maker-lab-9000/pi-film-reversal/docs/sticks3-remote.md

# StickS3 remote capture and Pi deployment

This guide connects the M5StickS3 button to the Pi's authenticated capture API.
The Pi runs its own Wi-Fi hotspot and the Stick joins it directly; no home
network sits between them. Administration (SSH, photo transfer, updates) goes
over an Ethernet cable, either straight into a laptop or into a router.

The examples use account `george`, hostname `pifilm`, project checkout
`/home/george/repos/pi-film-reversal`, hotspot `pifilm-cam` at `10.42.0.1`.
Keep credentials in the ignored local `.env`; never paste them into a shell
command, firmware source, service unit, terminal transcript, or Git commit.

## Local configuration

On the Mac or Pi checkout, make the local file with restrictive permissions:

```sh
cp .env.example .env
chmod 600 .env
```

Set these values in `.env`:

```dotenv
PI_HOST=parr.local
PI_USER=george
PI_PROJECT_DIR=/home/george/repos/pi-film-reversal
PI_SSH_PASSWORD=replace-locally
WIFI_SSID=pifilm-cam
WIFI_PASSWORD=replace-locally-8-to-63-ascii-characters
PIFILM_REMOTE_URL=http://10.42.0.1:8765
PIFILM_LISTEN=0.0.0.0:8765
PIFILM_REMOTE_TOKEN=replace-locally-with-a-long-random-token
PI_ARTIFACT_DIR=/home/george/repos/pi-film-reversal/pifilm/data
```

What each group means in this topology:

- `PI_HOST` is where SSH goes. Over Ethernet with avahi running on the Pi that
  is the mDNS name `parr.local`; a plain IP address also works.
- `WIFI_SSID` and `WIFI_PASSWORD` are the **Pi's hotspot** credentials. The
  Stick joins this network. WPA2 requires 8 to 63 printable ASCII characters.
- `PIFILM_REMOTE_URL` is the address the Stick calls. Its host must be a plain
  IPv4 address, and `scripts/pi_hotspot.py` gives the hotspot exactly that
  address, so the two can never disagree.
- `PIFILM_LISTEN` is where `pifilm-capture` binds on the Pi. `0.0.0.0:8765`
  listens on both the hotspot and Ethernet and avoids a boot-order race with
  NetworkManager bringing the hotspot address up.
- `PI_ARTIFACT_DIR` is the look the service loads. `pifilm/data` is the bundled
  untrained starter and exists in every checkout. A trained model under
  `artifacts/` is gitignored and must be copied to the Pi first. Whatever you
  choose, use the same path in the service unit's `--artifacts` and verify it
  on the Pi before starting capture: it must contain both `params.json` and
  `pifilm.cube`. Each capture's `captures.jsonl` record carries the `lut_sha1` of
  the look that graded it, so you can always tell which one was in use.

The scripts parse this file as `KEY=VALUE` data. They do not source it, expand
variables, run command substitutions, or execute any of its contents. The Pi
SSH password is used only for the SSH connection. The firmware generator passes
only Wi-Fi SSID, Wi-Fi password, API URL, and remote token to PlatformIO; it
never writes a credentials file and never passes `PI_SSH_PASSWORD` to firmware.
The hotspot script writes a root-only NetworkManager keyfile rather than passing
the passphrase on a command line.

Install the optional, cross-platform SSH dependency before using deployment:

```sh
.venv/bin/python --version  # requires Python 3.11 or newer
.venv/bin/python -m pip install --upgrade pip
.venv/bin/python -m pip install -e '.[deploy]'
```

If the environment uses an older Python, preserve it and recreate it first
(on macOS with Python 3.12 installed):

```sh
mv .venv .venv-old
python3.12 -m venv .venv
```

Then run the installation commands above. Pip 21.2.4 cannot install this
project in editable mode; upgrading pip fixes that error only when the Python
version also meets the project requirement.

## Network topology: Pi hotspot and Ethernet administration

The Pi 3B's onboard radio (2.4 GHz b/g/n) supports access-point mode with the
standard `brcmfmac` driver. The ESP32-S3 in the Stick is 2.4 GHz only, and the
firmware joins with `WiFi.begin(ssid, password)`, which is plain WPA2-PSK. No
firmware code changes are needed; only a rebuild with the hotspot's SSID,
passphrase and API URL.

One radio cannot reliably be a client of your home Wi-Fi and an access point at
the same time. **Activating the hotspot disconnects the Pi from home Wi-Fi.**
Do the steps below with an Ethernet cable connected, in this order.

Verified 2026-09-08 on a Pi 3B running Raspberry Pi OS Trixie (Debian 13),
NetworkManager 1.52.1 with netplan-generated profiles, brcmfmac firmware
7.45.98. Hotspot and capture service both return unattended after a reboot.

### 1. Ethernet administration (do this first)

Plug the Pi into your router, or directly into the laptop (the Pi 3B port is
auto-MDI-X, so any patch cable works). Log in and give the Pi a memorable name:

```sh
sudo raspi-config nonint do_hostname pifilm
```

Make the wired connection usable both behind a router (DHCP) and on a direct
cable with no DHCP server (IPv4 link-local, `169.254.x.y`):

```sh
nmcli -t -f NAME,TYPE connection show | grep ethernet   # find the wired profile name
sudo nmcli connection modify <wired-profile> ipv4.method auto ipv4.link-local enabled
nmcli -f ipv4.method,ipv4.link-local connection show <wired-profile>
```

The profile name depends on the OS release: Bookworm images call it
`Wired connection 1`; Trixie images, where netplan generates the
NetworkManager profiles, call it `netplan-eth0`. On Trixie, check that the
change was persisted and not only applied to the generated copy in `/run`:
a new `/etc/netplan/90-NM-<uuid>.yaml` (or a keyfile under
`/etc/NetworkManager/system-connections/`) should appear, and the property
must still read `enabled` after a reboot.

`ipv4.link-local` needs NetworkManager 1.40 or newer (`nmcli --version`);
Bookworm ships 1.42 and Trixie 1.52. If the property is missing, add a second
static profile on `192.168.7.2/24` and set the Mac's Ethernet adapter to
`192.168.7.1` instead.

avahi is installed by default on Raspberry Pi OS, and macOS resolves `.local`
names natively, so after a reboot both of these work with a direct cable:

```sh
ssh george@parr.local
ping parr.local
```

To give the Pi internet through the laptop for `apt` and `pip`, enable macOS
Internet Sharing from Wi-Fi to the Ethernet port; the Pi then receives a
`192.168.2.x` address over DHCP.

### 2. Wi-Fi country

Without a regulatory domain the radio stays soft-blocked and the hotspot will
not come up. Use your two-letter country code:

```sh
sudo raspi-config nonint do_wifi_country DE
```

### 3. Create the hotspot from `.env`

Copy the completed `.env` to the Pi checkout (mode 600), then preview the
NetworkManager keyfile the script will write. The passphrase is redacted in the
preview and nothing is written:

```sh
cd /home/george/repos/pi-film-reversal
.venv/bin/python scripts/pi_hotspot.py --env .env
```

With the Ethernet session confirmed working, apply it:

```sh
sudo .venv/bin/python scripts/pi_hotspot.py --env .env --apply
nmcli connection show --active
```

The script writes `/etc/NetworkManager/system-connections/pifilm-ap.nmconnection`
with mode 0600, reloads NetworkManager and activates `pifilm-ap`. The profile is
an access point on `wlan0`, WPA2-PSK only, `ipv4.method shared` (NetworkManager
runs a DHCP server for the Stick on the `/24` around the hotspot address and
NATs to Ethernet when that is up), `autoconnect` with priority 10. Re-running
with the same SSID produces the same connection UUID, so applying twice
replaces rather than duplicates.

The profile also sets `pmf=1`, which disables Protected Management Frames.
NetworkManager's default is "optional", and that makes hostapd install an
AES-CMAC group key when the access point starts. The Pi 3B and Zero W radio
(BCM43430, firmware 7.45.98) has no management-frame protection, `iw list`
shows no CMAC cipher, and the kernel rejects the key. The visible symptom is
`nmcli` failing with "802.1X supplicant took too long to authenticate" and
`journalctl -u wpa_supplicant` showing `key setting validation failed` followed
by `Failed to initialize AP interface`. The Pi 3B+ and Pi 4 radios do support
it, which is why generic hotspot recipes work there without this line. The
Stick does not use PMF, so nothing is lost.

If the Pi previously joined your home Wi-Fi, stop that profile from competing
at boot. The Imager-created profile is named `preconfigured` on Bookworm and
`netplan-wlan0-<SSID>` on Trixie; take the name from the listing:

```sh
nmcli -t -f NAME,TYPE connection show | grep wireless
sudo nmcli connection modify <home-wifi-profile> connection.autoconnect no
```

Expect 10 to 20 seconds after Pi boot before the hotspot is up. The firmware
already backs off reconnects between 1 and 10 seconds, so the Stick settles
into READY on its own.

### 4. Point the service and the firmware at the hotspot

The systemd example already listens on `0.0.0.0:8765`. Install or update it as
described in the next section, then rebuild and flash the Stick as described in
"Generate and flash StickS3 configuration" so it carries the hotspot SSID,
passphrase and `http://10.42.0.1:8765`.

The API is plain HTTP with a bearer token. On a private WPA2 hotspot with a
strong passphrase that is acceptable; keep the token anyway so a guest on the
hotspot cannot fire the shutter. The Ethernet side also sees port 8765 when
listening on `0.0.0.0`; the same token protects it.

### 5. Verify

From a phone or laptop joined to `pifilm-cam` (or from the Pi itself):

```sh
curl -s -H "Authorization: Bearer $PIFILM_REMOTE_TOKEN" http://10.42.0.1:8765/v1/status
```

Expect `"ready":true`. `"pi_battery"` is always present; it is `null` unless
the service runs with `--ups x728`. Allow up to 30 seconds after a boot
before the port answers: the service imports OpenCV, loads the LUT and warms
up the camera first, and on a Pi 3B that takes 15 to 25 seconds. Then power
the Stick: colour
bars, READY, one capture per deliberate press, graded thumbnail displayed. The
Stick's serial log shows each step; `firmware/sticks3/README.md` explains how to
read it and how to prove the displayed image is the graded file. The small side
button (BtnB) turns the Stick's screen off and back on to save battery; the
shutter keeps working while the screen is dark, and a new photo does not wake
it. Pull photos
over Ethernet with:

```sh
rsync -av george@parr.local:Pictures/pifilm/ ~/Pictures/pifilm-pi/
```
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
