maker-lab-9000/pi-film-reversal/camera-body/stl/bayonet_ring.stl

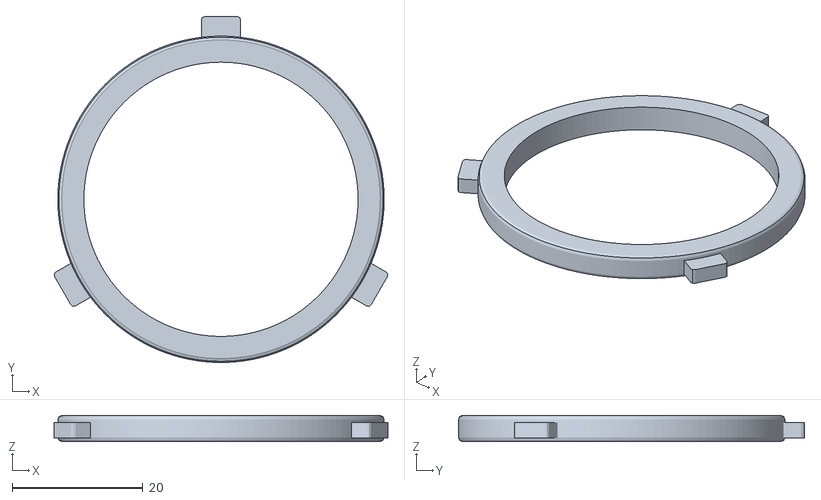
[picture p8: CAD file, 2026-11-12]
camera-body/stl/bayonet_ring.stl
51.1 x 53.0 x 4.00
