maker-lab-9000/pi-film-reversal/camera-body/stl/finder_base.stl

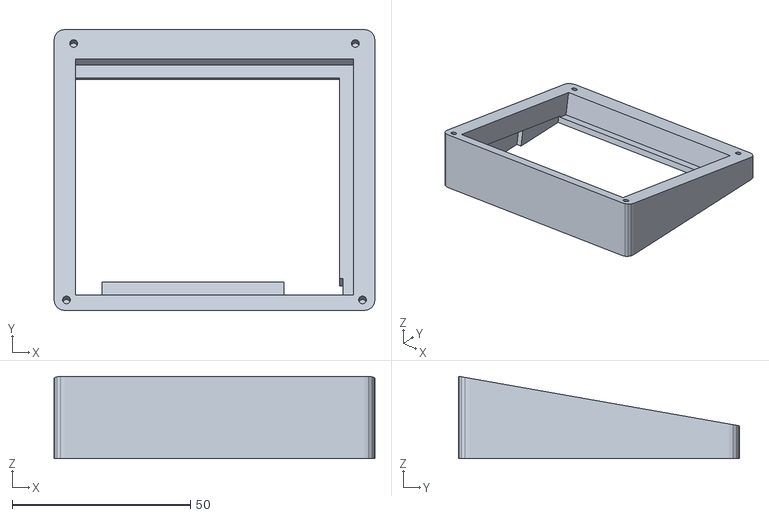
[picture p9: CAD file, 2026-11-12]
camera-body/stl/finder_base.stl
90.0 x 78.8 x 23.1
