maker-lab-9000/pi-film-reversal/camera-body/stl/sleeve.stl

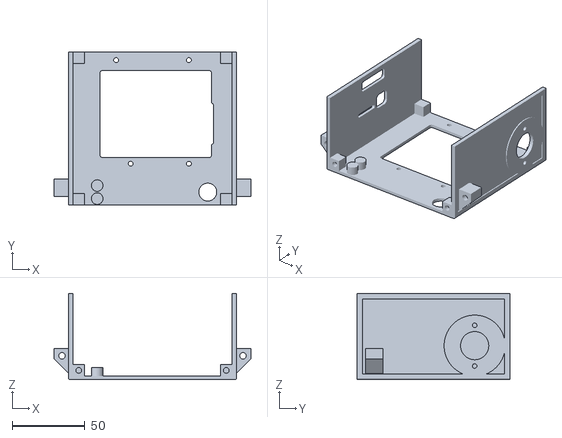
[picture p10: CAD file, 2026-11-12]
camera-body/stl/sleeve.stl
135.4 x 105.4 x 59.4
