maker-lab-9000/pi-film-reversal/camera-body/stl/base_plate.stl

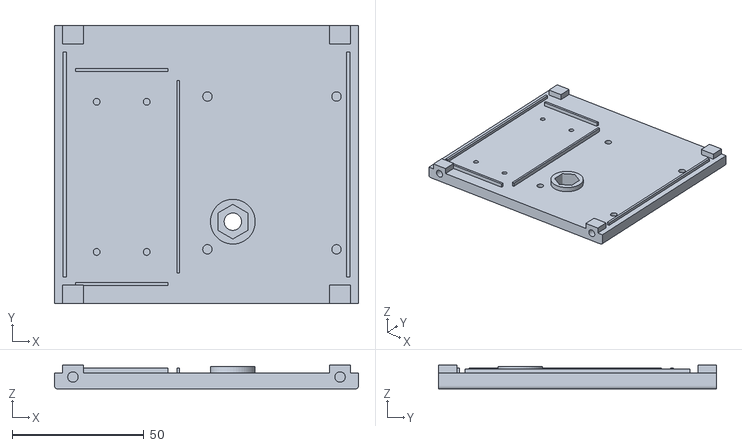
[picture p11: CAD file, 2026-11-12]
camera-body/stl/base_plate.stl
115.4 x 105.4 x 9.00
