maker-lab-9000/pi-film-reversal/camera-body/stl/power_knob.stl

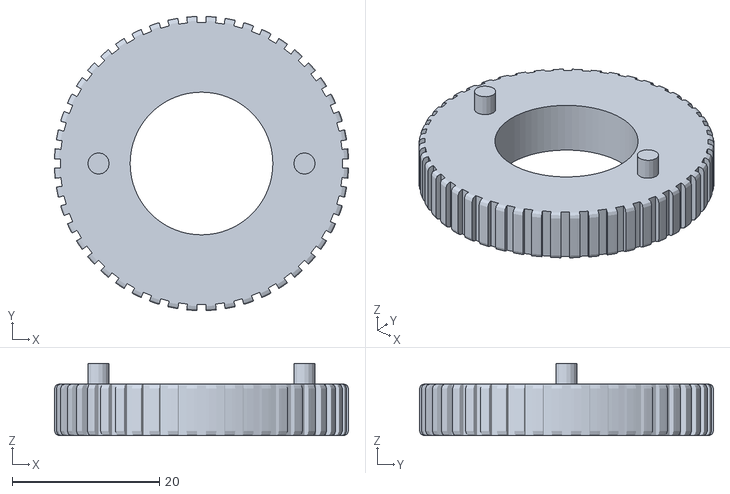
[picture p12: CAD file, 2026-11-12]
camera-body/stl/power_knob.stl
40.0 x 40.0 x 9.80
