maker-lab-9000/pi-film-reversal/camera-body/stl/coupon_right_wall.stl

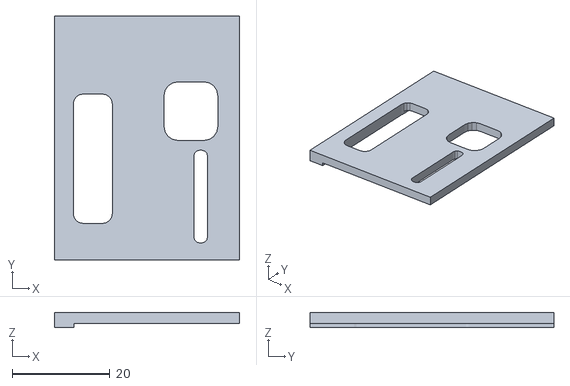
[picture p13: CAD file, 2026-11-12]
camera-body/stl/coupon_right_wall.stl
38.0 x 50.0 x 3.00
