maker-lab-9000/pi-film-reversal/camera-body/stl/lens_board.stl

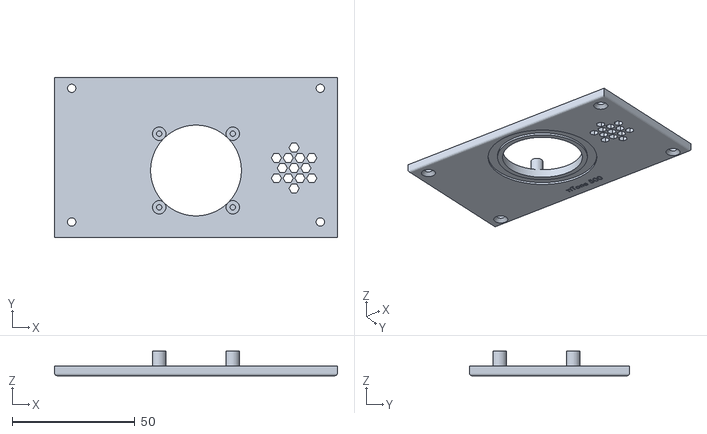
[picture p14: CAD file, 2026-11-12]
camera-body/stl/lens_board.stl
115.4 x 65.4 x 10.0
