maker-lab-9000/pi-film-reversal/camera-body/stl/cold_shoe.stl

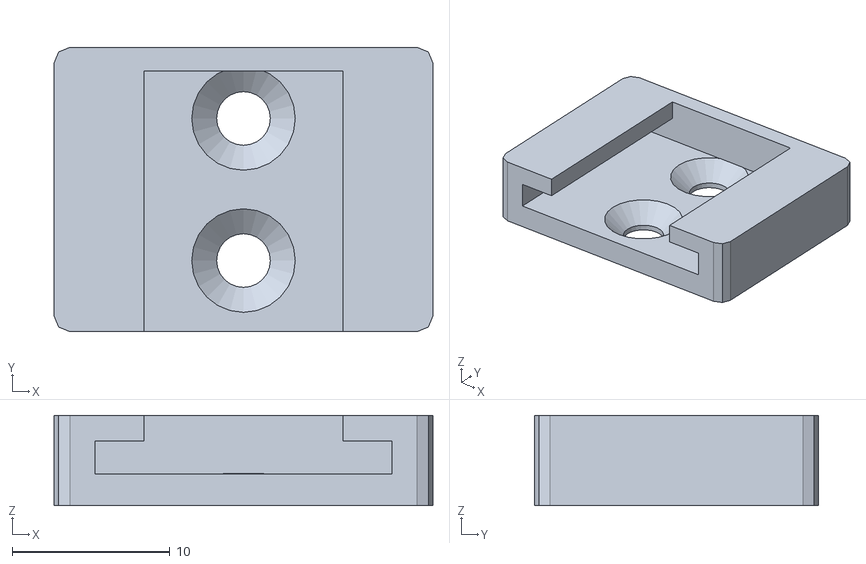
[picture p15: CAD file, 2026-11-12]
camera-body/stl/cold_shoe.stl
24.0 x 18.0 x 5.70
