maker-lab-9000/pi-film-reversal/camera-body/stl/shutter_collar.stl

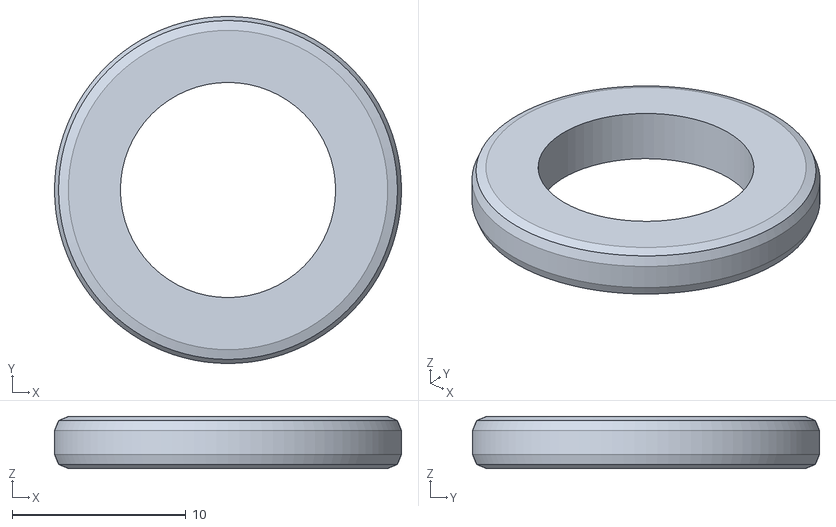
[picture p16: CAD file, 2026-11-12]
camera-body/stl/shutter_collar.stl
20.0 x 20.0 x 3.00
