maker-lab-9000/pi-film-reversal/camera-body/stl/hood_flap_l.stl

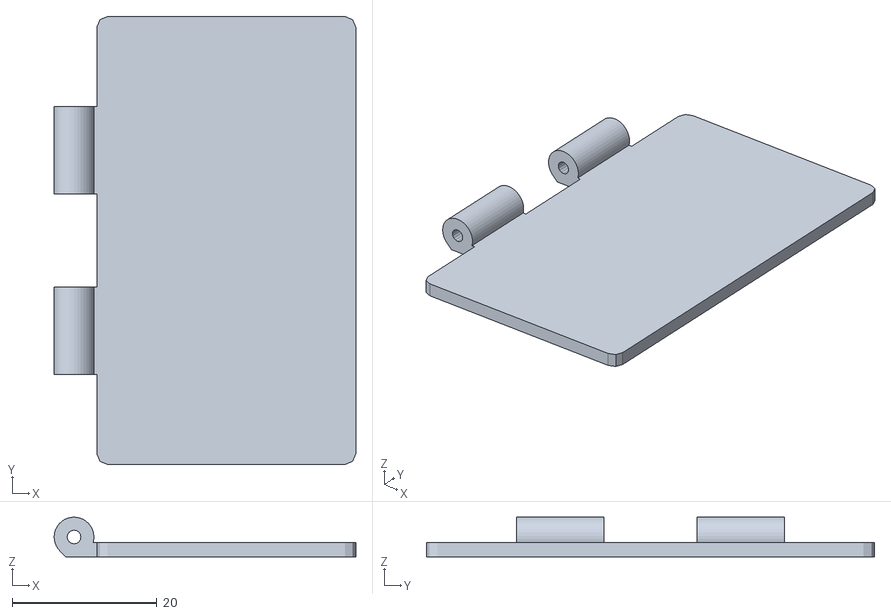
[picture p17: CAD file, 2026-11-12]
camera-body/stl/hood_flap_l.stl
41.7 x 62.0 x 5.50
