maker-lab-9000/pi-film-reversal/docs/superpowers/mockups/2026-10-11-manual-controls-ui.png

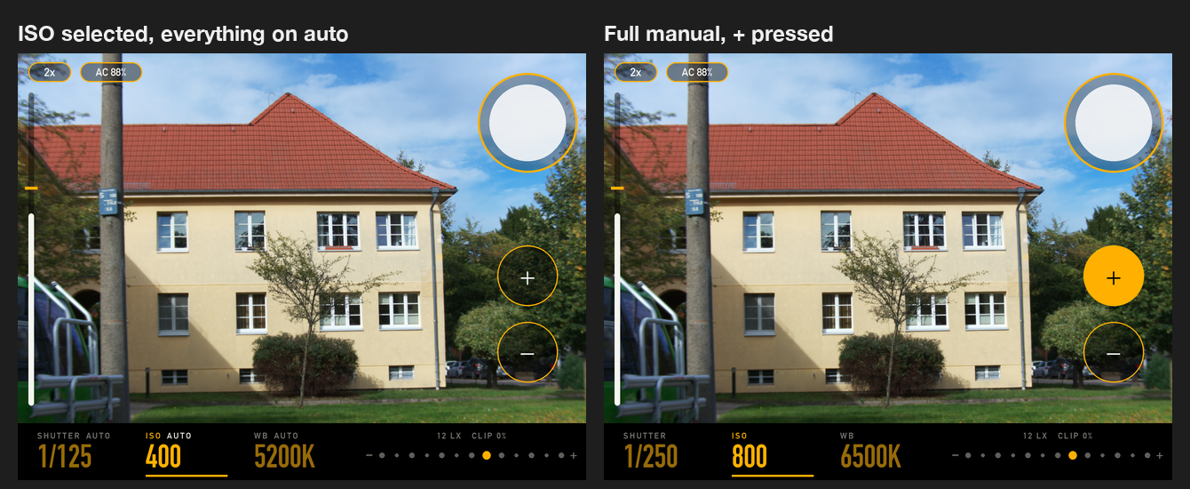
docs/superpowers/mockups/2026-10-11-manual-controls-ui.png
