maker-lab-9000/pi-film-reversal/tests/test_capture_controller.py

from __future__ import annotations

import threading
import time
from dataclasses import dataclass
from unittest.mock import Mock

import pytest

from pifilm.capture.camera import CameraError
from pifilm.capture.controller import CaptureController, ControllerSnapshot


@dataclass
class Result:
    value: str


class BlockingSession:
    def __init__(self) -> None:
        self.started = threading.Event()
        self.release = threading.Event()
        self.calls = 0
        self.camera = Mock()

    def capture(self) -> Result:
        self.calls += 1
        self.started.set()
        self.release.wait(timeout=2)
        return Result("saved")


def wait_for(controller, request_id: str, state: str):
    for _ in range(200):
        job = controller.status(request_id)
        if job is not None and job.state == state:
            return job
        threading.Event().wait(0.01)
    raise AssertionError(f"job {request_id!r} did not become {state!r}")


def test_controller_captures_once_for_an_accepted_request():
    """Removing the single worker's capture call would leave the job unfinished."""
    from pifilm.capture.controller import CaptureController

    session = BlockingSession()
    controller = CaptureController(session)
    try:
        accepted = controller.submit("first")
        assert accepted.request_id == "first"
        assert accepted.state in {"queued", "processing"}
        assert session.started.wait(timeout=1)
        assert session.calls == 1
        session.release.set()
        complete = wait_for(controller, "first", "complete")
        assert complete.result == Result("saved")
        assert session.calls == 1
    finally:
        session.release.set()
        controller.close()


def test_controller_allows_only_one_active_job_and_returns_busy_for_another_id():
    """Dropping the active-job guard would start a second camera capture."""
    from pifilm.capture.controller import CaptureController

    session = BlockingSession()
    controller = CaptureController(session)
    try:
        controller.submit("first")
        assert session.started.wait(timeout=1)
        busy = controller.submit("second")
        assert busy.request_id == "second"
        assert busy.state == "failed"
        assert busy.error_code == "busy"
        assert controller.status("second") is None
        assert session.calls == 1
    finally:
        session.release.set()
        controller.close()


def test_controller_duplicate_id_returns_the_original_job_without_recapturing():
    """Treating a duplicate as new would make retries expose the camera twice."""
    from pifilm.capture.controller import CaptureController

    session = BlockingSession()
    controller = CaptureController(session)
    try:
        original = controller.submit("same")
        assert session.started.wait(timeout=1)
        duplicate = controller.submit("same")
        assert duplicate == controller.status("same")
        assert duplicate.request_id == original.request_id
        assert duplicate.error_code is None
        assert session.calls == 1
    finally:
        session.release.set()
        controller.close()


def test_camera_error_finishes_job_and_allows_a_later_request():
    """Keeping a failed job active would make the camera permanently busy."""
    from pifilm.capture.controller import CaptureController

    class FlakySession:
        def __init__(self) -> None:
            self.calls = 0
            self.camera = Mock()

        def capture(self):
            self.calls += 1
            if self.calls == 1:
                raise CameraError("dropped frame")
            return Result("recovered")

    session = FlakySession()
    controller = CaptureController(session)
    try:
        failed = wait_for(controller, controller.submit("failed").request_id, "failed")
        assert failed.error_code == "camera_error"
        complete = wait_for(controller, controller.submit("retry").request_id, "complete")
        assert complete.result == Result("recovered")
        assert session.calls == 2
    finally:
        controller.close()


def test_snapshots_are_immutable_values():
    """Mutating a returned status must not change the controller's published state."""
    from dataclasses import FrozenInstanceError

    from pifilm.capture.controller import CaptureController

    session = BlockingSession()
    controller = CaptureController(session)
    try:
        job = controller.submit("first")
        try:
            job.state = "failed"
        except FrozenInstanceError:
            pass
        else:
            raise AssertionError("job snapshot was mutable")
    finally:
        session.release.set()
        controller.close()


class _Session:
    def __init__(self, fail=False):
        self.camera = None
        self.fail = fail

    def capture(self):
        if self.fail:
            raise CameraError("boom")
        return "result"


def _wait_finished(controller, request_id, timeout=2.0):
    deadline = time.monotonic() + timeout
    while time.monotonic() < deadline:
        job = controller.status(request_id)
        if job is not None and job.state in ("complete", "failed"):
            return job
        time.sleep(0.005)
    raise AssertionError("job did not finish")


def test_snapshot_counts_finished_jobs_of_both_states():
    controller = CaptureController(_Session())
    try:
        assert controller.snapshot().finished_count == 0
        assert controller.snapshot().last_finished_job is None
        controller.submit("a")
        _wait_finished(controller, "a")
        snap = controller.snapshot()
        assert snap.finished_count == 1
        assert snap.last_finished_job.request_id == "a"
        assert snap.last_finished_job.state == "complete"
    finally:
        controller.close()


def test_failed_job_counts_as_finished_but_not_completed():
    controller = CaptureController(_Session(fail=True))
    try:
        controller.submit("b")
        _wait_finished(controller, "b")
        snap = controller.snapshot()
        assert snap.finished_count == 1
        assert snap.last_finished_job.state == "failed"
        assert snap.last_completed_job is None
    finally:
        controller.close()


class DoubleSession:
    """Minimal session with the double-exposure surface of ``CaptureSession``."""

    def __init__(self) -> None:
        self.camera = Mock()
        self.enabled = False
        self.taken = 0
        self.started = threading.Event()
        self.release = threading.Event()
        self.release.set()

    @property
    def double_state(self):
        return self.enabled, self.taken

    def set_double_exposure(self, enabled):
        self.enabled = enabled
        if not enabled:
            self.taken = 0

    def capture(self):
        self.started.set()
        self.release.wait(timeout=2)
        if self.enabled:
            self.taken = (self.taken + 1) % 2
        return Result("saved")


def _until(pred):
    for _ in range(200):
        if pred():
            return
        threading.Event().wait(0.01)
    raise AssertionError("condition not met")


def test_double_exposure_toggle_reaches_the_snapshot():
    session = DoubleSession()
    controller = CaptureController(session)
    try:
        assert controller.snapshot().double_exposure is False
        controller.set_double_exposure(True)
        _until(lambda: controller.snapshot().double_exposure)
        assert controller.snapshot().exposures_taken == 0
    finally:
        controller.close()


def test_a_finished_job_and_its_exposure_count_arrive_in_one_snapshot():
    """A display must never see exposure 1 finished with the count still at 0."""
    session = DoubleSession()
    controller = CaptureController(session)
    try:
        controller.set_double_exposure(True)
        _until(lambda: controller.snapshot().double_exposure)
        controller.submit("one")
        _until(lambda: controller.snapshot().finished_count == 1)
        snap = controller.snapshot()
        assert snap.finished_count == 1 and snap.exposures_taken == 1
    finally:
        controller.close()


def test_a_toggle_sent_during_a_capture_applies_after_it():
    session = DoubleSession()
    session.enabled = True
    session.release.clear()
    controller = CaptureController(session)
    try:
        controller.submit("busy")
        assert session.started.wait(timeout=1)
        controller.set_double_exposure(False)
        assert session.enabled is True  # not applied mid-capture
        session.release.set()
        _until(lambda: controller.snapshot().double_exposure is False)
        assert controller.snapshot().finished_count == 1
    finally:
        session.release.set()
        controller.close()


def test_a_session_without_double_exposure_ignores_the_toggle():
    session = BlockingSession()
    session.release.set()
    controller = CaptureController(session)
    try:
        controller.set_double_exposure(True)
        controller.submit("plain")
        wait_for(controller, "plain", "complete")
        assert controller.snapshot().double_exposure is False
    finally:
        controller.close()


def test_a_toggle_that_raises_does_not_stop_the_worker():
    class BrokenToggle(DoubleSession):
        def set_double_exposure(self, enabled):
            raise RuntimeError("toggle failed")

    controller = CaptureController(BrokenToggle())
    try:
        controller.set_double_exposure(True)
        controller.submit("after")
        assert _wait_finished(controller, "after").state == "complete"
        assert controller.snapshot().double_exposure is False
    finally:
        controller.close()


def test_an_unreadable_double_state_keeps_the_last_known_value():
    class Flaky(DoubleSession):
        broken = False

        @property
        def double_state(self):
            if self.broken:
                raise RuntimeError("state unavailable")
            return self.enabled, self.taken

    session = Flaky()
    controller = CaptureController(session)
    try:
        controller.set_double_exposure(True)
        _until(lambda: controller.snapshot().double_exposure)
        session.broken = True
        controller.submit("x")
        assert _wait_finished(controller, "x").state == "complete"
        assert controller.snapshot().double_exposure is True
    finally:
        controller.close()


class GradingSession:
    """Minimal session with the background-grading surface of ``CaptureSession``."""

    def __init__(self, events=None, fail_close=False) -> None:
        self.events = events if events is not None else []
        self.camera = Mock()
        self.camera.close.side_effect = lambda: self.events.append("camera")
        self.pending_grades = 0
        self.fail_close = fail_close

    def capture(self):
        return Result("saved")

    def close_grades(self, timeout=None):
        self.events.append("grades")
        if self.fail_close:
            raise RuntimeError("grades would not close")
        return True


def test_snapshot_follows_the_sessions_pending_grades():
    session = GradingSession()
    controller = CaptureController(session)
    try:
        assert controller.snapshot().pending_grades == 0
        session.pending_grades = 2
        assert controller.snapshot().pending_grades == 2
        session.pending_grades = 0
        assert controller.snapshot().pending_grades == 0
    finally:
        controller.close()


def test_a_session_without_pending_grades_reports_none():
    controller = CaptureController(_Session())
    try:
        assert controller.snapshot().pending_grades == 0
    finally:
        controller.close()


def test_unusable_pending_grades_report_none():
    """A display draws this number on every frame; it must never raise there."""

    class Raising(GradingSession):
        @property
        def pending_grades(self):
            raise RuntimeError("queue unavailable")

        @pending_grades.setter
        def pending_grades(self, value):
            pass

    for session in (Raising(), BlockingSession()):  # the second has no such attribute
        controller = CaptureController(session)
        try:
            assert controller.snapshot().pending_grades == 0
        finally:
            getattr(session, "release", threading.Event()).set()
            controller.close()
    odd = GradingSession()
    controller = CaptureController(odd)
    try:
        for value in ("3", None, 2.5, True, -1):
            odd.pending_grades = value
            assert controller.snapshot().pending_grades == 0
    finally:
        controller.close()


def test_close_finishes_the_grades_before_closing_the_camera():
    """The camera's close can hang on a stalled sensor; the grades must not wait on it."""
    session = GradingSession()
    controller = CaptureController(session)
    controller.close()
    assert session.events == ["grades", "camera"]
    controller.close()  # a second close is harmless
    assert session.events == ["grades", "camera"]


def test_close_still_closes_the_camera_when_the_grades_will_not_close():
    session = GradingSession(fail_close=True)
    controller = CaptureController(session)
    controller.close()
    assert session.events == ["grades", "camera"]


def test_snapshot_carries_the_sessions_tuning_mismatch():
    session = GradingSession()
    session.tuning_mismatch = True
    controller = CaptureController(session)
    try:
        assert controller.snapshot().tuning_mismatch is True
        session.tuning_mismatch = False
        assert controller.snapshot().tuning_mismatch is False
    finally:
        controller.close()


def test_a_session_without_tuning_mismatch_reports_false():
    controller = CaptureController(_Session())
    try:
        assert controller.snapshot().tuning_mismatch is False
    finally:
        controller.close()


def test_unusable_tuning_mismatch_reports_false():
    """Read on every frame like the developing count; it must never raise there."""

    class Raising(GradingSession):
        @property
        def tuning_mismatch(self):
            raise RuntimeError("no session state")

    controller = CaptureController(Raising())
    try:
        assert controller.snapshot().tuning_mismatch is False
    finally:
        controller.close()
    odd = GradingSession()
    controller = CaptureController(odd)
    try:
        for value in ("yes", 1, None):
            odd.tuning_mismatch = value
            assert controller.snapshot().tuning_mismatch is False
    finally:
        controller.close()


def test_snapshot_carries_the_sessions_disk_warning():
    session = GradingSession()
    session.disk_warning = (("PHOTOS", 92), ("SD", 91))
    controller = CaptureController(session)
    try:
        assert controller.snapshot().disk_warning == (("PHOTOS", 92), ("SD", 91))
        session.disk_warning = ()
        assert controller.snapshot().disk_warning == ()
    finally:
        controller.close()


def test_a_session_without_disk_warning_reports_none():
    controller = CaptureController(_Session())
    try:
        assert controller.snapshot().disk_warning == ()
    finally:
        controller.close()


def test_disk_warning_comes_before_network_and_defaults_to_empty():
    from dataclasses import fields

    assert [f.name for f in fields(ControllerSnapshot)][-2] == "disk_warning"
    assert ControllerSnapshot(None, None, False).disk_warning == ()


@pytest.mark.parametrize("value", [
    None, "PHOTOS 92%", [("PHOTOS", 92)], (("PHOTOS", "92"),), (("PHOTOS", True),),
    (("PHOTOS",),), ((7, 92),), (("PHOTOS", 92, 1),),
])
def test_unusable_disk_warning_reports_none(value):
    """Read on every frame like the developing count; anything odd reads as none."""
    session = GradingSession()
    session.disk_warning = value
    controller = CaptureController(session)
    try:
        assert controller.snapshot().disk_warning == ()
    finally:
        controller.close()


def test_a_raising_disk_warning_reports_none():
    class Raising(GradingSession):
        @property
        def disk_warning(self):
            raise RuntimeError("no session state")

    controller = CaptureController(Raising())
    try:
        assert controller.snapshot().disk_warning == ()
    finally:
        controller.close()


def test_snapshot_carries_the_sessions_network_addresses():
    session = GradingSession()
    session.network = (("ETH", "192.168.1.20"), ("WLAN", "10.42.0.1"))
    controller = CaptureController(session)
    try:
        assert controller.snapshot().network == (("ETH", "192.168.1.20"), ("WLAN", "10.42.0.1"))
        session.network = ()
        assert controller.snapshot().network == ()
    finally:
        controller.close()


def test_a_session_without_network_reports_none():
    controller = CaptureController(_Session())
    try:
        assert controller.snapshot().network == ()
    finally:
        controller.close()


def test_network_is_the_last_snapshot_field_and_defaults_to_empty():
    from dataclasses import fields

    assert [f.name for f in fields(ControllerSnapshot)][-1] == "network"
    assert ControllerSnapshot(None, None, False).network == ()


@pytest.mark.parametrize("value", [
    None, "ETH 192.168.1.20", [("ETH", "192.168.1.20")], (("ETH", 7),),
    (("ETH",),), ((7, "192.168.1.20"),), (("ETH", "192.168.1.20", 1),),
])
def test_unusable_network_reports_none(value):
    """Read on every frame like the developing count; anything odd reads as none."""
    session = GradingSession()
    session.network = value
    controller = CaptureController(session)
    try:
        assert controller.snapshot().network == ()
    finally:
        controller.close()


def test_a_raising_network_reports_none():
    class Raising(GradingSession):
        @property
        def network(self):
            raise RuntimeError("no session state")

    controller = CaptureController(Raising())
    try:
        assert controller.snapshot().network == ()
    finally:
        controller.close()
