maker-lab-9000/pi-film-reversal/(commit log)

2026-09-20 Document the face/skin-tone darkening and a measured fix suggestion
    One indoor Pi 4 frame (154239, 2026-09-20) loses a third of skin luminance under
    the starter LUT while the Phase 6 normaliser is a no-op on it: the S-curve
    darkens mid-shade skin and the 1.45x chroma boost turns it red-orange. The
    never-evaluated shadows control in experiments/candidates.py recovers skin
    lightness to within 0.011 of the original with under one 8-bit step of change
    elsewhere. Recorded as a suggestion only; more frames with faces, above all
    outdoors, are needed before touching the bundled starter.
2026-09-24 Count finished capture jobs on the controller snapshot
    Add ControllerSnapshot.finished_count and last_finished_job so a
    future LCD display can poll for any job that ended, complete or
    failed, regardless of which trigger (Stick, SPACE, LCD) submitted it.
    last_completed_job keeps its existing complete-only meaning for the
    remote server.
    [controller.py, test_capture_controller.py]
2026-09-24 Picamera2 backend: native size from the sensor, automatic tuning, fixed-lens sensors
    The backend was written against the IMX708 only: 4608x2592 hard-coded,
    imx708_wide.json loaded by default, and AfMode/AfRange set unconditionally.
    An IMX477 (4056x3040, 12-bit raw, fixed C/CS mount, no AfMode control) could
    not be opened at all.
    Native size now comes from Picamera2.sensor_resolution and is carried on
    self._native_size, used by create_still_configuration, the negotiated-config
    check and the frame shape check. Tuning defaults to libcamera's own choice for
    the detected sensor and is recorded as "auto:<Model>"; --tuning-file still
    pins a specific file. Autofocus controls are applied only when t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
    [app.py, camera.py, picamera.py, test_app.py, test_picamera.py]
2026-09-24 Picamera2 preview mode with per-shot mode switch, request lock and runtime EV
    The LCD viewfinder needs cheap frames on one thread while the capture
    controller takes full-resolution stills on another. The still configuration is
    still configured and validated first, so stream_info describes the shot; the
    binned preview configuration is then applied on top, and each full read uses
    switch_mode_and_capture_request, which restores the preview configuration
    itself. One lock spans request acquisition through release because the buffer
    belongs to the request, and set_ev takes the same lock.
    Without preview=, the configuration calls and read path are unchanged.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
2026-09-24 Fail loudly when Picamera2 cannot describe its own capabilities
    camera_controls and camera_properties were read through getattr with {}
    defaults while sensor_resolution on the neighbouring line was accessed
    directly. A camera missing its control set therefore fell into the
    fixed-lens path and, with --autofocus auto, reported "<model> has no
    autofocus" — sending the user after their flag instead of the real fault.
    A missing camera_properties was quieter still: the model silently became
    "unknown" and the capture was recorded as tuning_file auto:unknown.
    Both are now read directly, so a missing attribute surfaces through the
    existing constructor wrapper ("Failed to configure or start Picamer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
    [picamera.py, test_picamera.py]
2026-09-24 ST7789 driver for the Waveshare 2.8" LCD with a NumPy frame push
2026-09-24 CST3530 touch driver with rotation mapping and tap detection
2026-09-24 Keep stream_info describing the still, in the fake as well as the camera
    The fake's camera_configuration() returned one constant configuration, so the
    test that says stream_info is built before the preview configure would have
    passed even if it were built after. It now derives its answer from whatever was
    last configured, like Picamera2 does, and building stream_info after the
    preview configure fails loudly.
    stream_info is also the audit of the still that goes into every capture record,
    so only a full read may set its measured frame rate; a binned viewfinder frame
    would otherwise make a record claim the wrong rate.
    [picamera.py, test_picamera.py]
2026-09-24 Exposure meter readout from preview frame and metadata
2026-09-24 Viewfinder renderer: live frame with meter bar, review, messages, hit regions
2026-09-24 Viewfinder loop: live view, shutter and EV taps, review, Stick shots
    LIVE reads a preview frame, meters it and draws the overlay; a shutter tap
    submits through the shared CaptureController so the LCD is one more trigger,
    never a second owner of the camera. Any finished job, whoever triggered it,
    is noticed through the controller's finished_count and shown in REVIEW until
    a tap or the review timeout. The loop never closes the camera: the caller
    stops it through the stop event and then closes the controller.
2026-09-24 Fix: EV-minus and missing-value placeholders render as tofu boxes under default font
    ImageFont.load_default's bundled bitmap font has no glyph for U+2212 (minus
    sign) or U+2014 (em dash); both rasterise as hollow square boxes rather than
    a dash, unlike ASCII "-". Replace all uses in pifilm/display/ui.py with ASCII
    "-" and add a test proving the glyph renders as a short stroke, not a box.
    [test_display_ui.py, ui.py]
2026-09-24 pifilm-capture --display: LCD viewfinder wiring with headless fallback
2026-09-24 Viewfinder fixes: OpenCV-free import, guarded review, touch glitches survived
    Four review findings.
    CameraError moves to a new pifilm/capture/errors.py, which imports nothing
    third-party, and camera.py re-exports it so every existing importer is
    unchanged. The viewfinder took it from camera.py, whose module scope runs
    require_cv2(), which made pifilm/display require OpenCV -- a base dependency
    this package deliberately does not have.
    _review_image now builds its caption from compute_reading instead of its own
    arithmetic, so the meter's guards apply and the review agrees with the live
    readout; ExposureTime 0 raised ZeroDivisionError and a non-numeric value
    TypeError, and ISO ignored Digital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
    [camera.py, errors.py, test_viewfinder.py, viewfinder.py]
2026-09-24 Document the LCD viewfinder: wiring, setup, screen, meter, acceptance
2026-09-24 Picamera2: neutral controls in both configs, aspect-correct preview, no mode scan
    Three defects found in the whole-branch review of the preview-mode backend:
    * Picamera2 resets its controls to the configuration's own ``controls`` dict on
    every ``configure``, and ``switch_mode_and_capture_request`` configures twice
    per shot, so the still was taken with the ISP's default sharpening,
    saturation and noise reduction and the viewfinder came back without them.
    The neutral set is now built once and handed to both configurations as well
    as to ``set_controls``; ``set_ev`` updates both configuration dicts too, so a
    runtime EV change survives the next mode switch.
    * ``PREVIEW_SIZE = (640, 4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
    [picamera.py, test_picamera.py]
2026-09-24 --display: warn on V4L2, open the panel first, survive a dead screen
    Three faults the shipped service unit would hit, since it passes
    ``--display waveshare28`` on every deployment:
    * On a V4L2 deployment (``--camera v4l2``, ``--device``, or no Picamera2
    installed) ``--display`` was a parser error: exit 2, restarted by systemd,
    forever. It now prints one warning and runs without a display.
    * The camera was opened in preview mode before the display was tried, so a
    display fault left the process "continuing without it" with the camera stuck
    in a continuous binned stream plus a mode switch per Stick shot. The panel is
    now opened first and ``preview=`` is passed only when it is there.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
    [app.py, test_app.py]
2026-09-24 Touch: probe the controller on open, keep TP_RST, rate-limit read errors
    Opening the touch controller never verified that anything answers: with no
    panel connected ``open_waveshare28_touch`` succeeded and every frame's
    ``read()`` raised, so the loop logged an I2C error at 10 Hz forever instead of
    falling back. It now reads one report at open and raises ``DisplayError`` when
    the controller does not answer, and the loop's touch-error log is rate-limited
    to one line per ten seconds with a count of the ones it swallowed.
    TP_RST was also closed immediately after the reset pulse, returning GPIO 17 to
    input and possibly leaving the controller in reset; the device is now owned by
    ``CST3530Touch`` a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
    [cst3530.py, test_display_cst3530.py, test_viewfinder.py, viewfinder.py]
2026-09-24 Viewfinder: honest frame rate, one dash constant, no dead font fallback
    The printed frame rate is what the hardware acceptance checklist is read
    against, and it averaged in the up-to-30 s review screen and stretches of
    camera errors as if they were dropped frames; the window now restarts when the
    loop leaves REVIEW or a preview read fails. The review caption's "-" and
    "ISO -" placeholders are the renderer's own ``DASH``/``text_or_dash``/
    ``iso_label`` instead of duplicated literals, and the Pillow < 10.1 font
    fallback is removed: the packaging floor is 10.1.
    [test_display_ui.py, test_viewfinder.py, ui.py, viewfinder.py]
2026-09-24 Docs: the unit's display fallback, a testable panel fault, and what SPACE is not
    Brings the guides in line with the review fixes:
    * the unit runs the LCD viewfinder when a panel is present and falls back to
    headless Stick-only otherwise, including on a V4L2 Pi where --display is now
    one warning line (service Description, CLAUDE.md, docs/setup.md, the guide);
    * hardware-acceptance item 7 asked for a fault the open path cannot detect -
    SPI writes are not acknowledged, so an unplugged DC wire looks exactly like a
    working panel. It now unplugs the ribbon (the touch probe fails) or drops the
    spi group;
    * the SPACE key is not a trigger while the viewfinder owns the main thread: the
    tr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
2026-09-24 Resolve the camera backend before opening the LCD panel
    With no --camera flag the backend can still resolve to V4L2 (no Picamera2
    installed, or --device given). Opening the panel first claimed SPI, GPIO and
    I2C only to print "continuing without it" a moment later, and left
    ``display_pair`` set, so the viewfinder would have run against a V4L2 camera.
    [app.py, test_app.py]
2026-09-24 Check --fake argument conflicts before touching the panel; fix spec I2C wording
    Re-review residuals of the final fix wave: the panel was opened (SPI, GPIO,
    I2C claimed, TP_RST pulsed) before argparse rejected a Picamera2-only flag
    combined with --fake, so a usage error had a hardware side effect. The spec's
    §3.2 and §7 still said a touch poll is "two short transactions" next to the
    amendment that corrected it to eleven transfers.
    [app.py]
2026-09-24 Viewfinder: colour bars while a shot is graded, not a busy dot
    The first run on the real panel showed the problem: during the roughly
    three seconds of grading the LCD kept a stale live view with a small amber
    dot in the corner, which reads as "nothing happened", and it kept reading
    the camera for frames nobody could act on.
    The LIVE state now checks for an active job before touching the camera and
    shows the same TV colour bars the Stick and the Pi's OpenCV window already
    show, once per job rather than at 10 fps. Touch is still polled every step,
    so a shutter tap during a grade still reaches the controller (which answers
    busy) and EV taps still work. The frame-rate window restarts when live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
    [test_display_ui.py, test_viewfinder.py, ui.py, viewfinder.py]
2026-09-24 Stick: the side button turns the screen off and on
    The panel's backlight is the Stick's largest steady draw, and on a long shoot
    the screen is mostly not being looked at. BtnB now toggles it: DisplayPower
    (a pure, Arduino-free module, like the capture state machine, and covered by
    the native Unity tests) debounces the button with the same 30 ms window as the
    shutter and toggles on the release edge, so holding the button cannot repeat.
    StickDisplay::setPower drops the brightness to zero and sleeps the panel, and
    render()/drawBatteryBadge() draw nothing while it is off. Captures continue in
    the dark: main.cpp still decodes and stores each thumbnail, and the shutter
    tone remains the feedback.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
2026-09-24 Docs: which Stick button does what
    The firmware README gains a Buttons section (M5 button shutter, side button
    screen off/on, power button untouched) and the annotated healthy log gains the
    `ui: display off (BtnB)` line, which is also the first thing to check when the
    screen looks dead but the log says a photo was drawn.
2026-09-24 LCD: a focus bar for the manual lens
    The IMX477 has no autofocus, so the ring is turned by hand with nothing on
    screen to say which way is better. Add a sharpness gauge down the left edge of
    the viewfinder: it grows as the image sharpens, drops the moment focus is racked
    past, and carries an amber tick at the peak to turn the ring towards.
    The score is the variance of a 4-neighbour Laplacian over the frame's central
    quarter, sliced with numpy so pifilm/display keeps needing no OpenCV: 0.5 ms on
    a 640x480 preview, inside a 100 ms frame period, so the full-resolution centre
    is read rather than a subsampled one.
    Its absolute value means nothing - it scales with the scene's own contrast - so
    F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
2026-09-24 Focus bar: absolute sharpness, so an out-of-focus lens reads low
    The bar was a Laplacian variance against its own decaying peak, and on the
    IMX477 a lens left out of focus read full: with no sharp frame seen, the
    blurred frame was the peak. focus_score is now the Crete-Roffet blur ratio,
    which cancels scene contrast, with edges chosen by the noise-free re-blurred
    step and noise's own contribution subtracted. The tracker only places the
    best-seen tick.
    [meter.py, test_display_meter.py, test_display_ui.py, test_viewfinder.py, ui.py, viewfinder.py]
2026-09-24 EV compensation reaches the graded file
    The camera honoured the viewfinder's EV, but per-image normalisation brought
    every frame back to one exposure: -2 EV originals came out 2.2 stops darker
    and graded identically. The pipeline now takes the compensation out, normalises
    the frame as the plain exposure it would have been, and puts it back before the
    LUT; the value is logged as ev_comp.
2026-09-24 deploy_remote: guard the restart with the service's real name and owners
    The capture process was searched for as parr-capture (pre-rename) and camera
    owners were read from fuser -v's stdout, which carries only PIDs, so the guard
    could not tell PipeWire's passive device handles from a competitor and refused
    every restart on a Pi with a desktop session. Owners are now named with ps and
    the desktop media monitors allowed; presence checks print present/missing.
    [test_deployment.py]
2026-09-30 Service example: --ae-constraint highlight; note it in the IMX477 retrain doc
    35 of 98 EV-0 IMX477 frames clipped more than 1% of pixels at the sensor
    under the default normal constraint, which only raises exposure.
2026-09-30 Double exposure: linear-light composite of two frames
2026-09-30 Double exposure: capture session composites two frames, grades once
2026-09-30 pifilm-train: --source-gamma-min/--source-gamma-max
    The levels gamma clamp (0.5 to 2.0) lifted a deliberately dark IMX477
    street scene to slate grey and crushed a face against a white wall to a
    tenth of its brightness. The limits are recorded in params.json, so the
    Pi clamps exactly as the LUT was trained.
2026-09-30 Double exposure: table-driven float32 composite in row bands
    A full-sensor pair peaked near 741 MiB of float64 temporaries and took ~4.9 s
    on a Mac. Decode through a 256-entry table, add in float32, encode the mean
    through a 65536-level table, 256 rows at a time: ~0.43 s and ~58 MiB peak
    including the 35 MiB output. A slow test checks a 3040x4056 random pair
    against a float64 reference within one code.
2026-09-30 Double exposure: survive a cleaned card dir, log after the card, relative originals
    systemd-tmpfiles ages /tmp under the long-running service, so the card
    directory is re-created when it has gone. Exposure 1 renders its card before
    appending its jsonl line, so a failed exposure 1 logs nothing. double.originals
    are now paths relative to the output folder, so a pair across midnight names
    both day folders.
    [app.py, test_double_capture.py]
2026-09-30 Double exposure: 2x review caption shows the pair's recorded EVs
    The composite is graded at EV 0 from frames shot at record double.ev_comp, so
    the caption reads 'EV e1/e2' from the record rather than the dial's current EV,
    falling back to the dial when the record lacks them.
2026-09-30 Double exposure: a failing toggle or state read cannot kill the worker
    _read_double and _apply_toggle run outside the capture try blocks; an
    exception there ended the worker and left the controller busy for good. The
    read now falls back to the last known state and the toggle swallows setter
    errors.
    [controller.py, test_capture_controller.py]
2026-09-30 Shutter priority: meter flags a fixed shutter and a saturated gain
    [meter.py, test_display_meter.py]
2026-09-30 Shutter priority: set_shutter on Picamera2 and the fake camera
2026-09-30 Shutter priority: shutter buttons, S readout and amber ISO MAX
2026-09-30 Shutter priority: set_shutter falls back to the camera's frame limits and refuses non-integral input
2026-09-30 Shutter priority: keep the fixed-shutter readout clear of the needle
    [test_display_ui.py, ui.py]
2026-09-30 Shutter priority: viewfinder shutter taps, metered start, meter and render wiring
2026-09-30 Shutter priority: document the buttons, readout, ISO MAX and acceptance
2026-09-30 Shutter priority: poll touch on its own thread so taps land at long exposures
    At 0.6-1 s the preview read blocks a whole frame, so a touch poll inside the
    frame loop ran about once a second and TapDetector (0.6 s hold limit) never saw
    a quick tap go down and up. run() now starts a "pifilm-touch" thread that polls
    the panel every touch_period of real time and queues taps; step() takes one per
    call. step() driven directly still polls inline, so existing tests are unchanged.
    The thread is stopped and joined when run() ends, including by exception.
2026-09-30 Shutter priority: tighten the ISO MAX, long-exposure tap and --ae-lock wording
    ISO MAX is "at or near" the maximum (98 % or more) and can show on auto in very
    dim light; at long speeds the screen answers taps once per frame; shutter
    priority and --ae-lock should not be combined. Rewrap CLAUDE.md's Display
    paragraph to 100 columns.
2026-09-30 pifilm-train: --source-max-stretch
    The levels stretch is a second lift besides the gamma: at its 4.0 default
    it brightened an IMX477 night frame by two stops on its own, so a gamma
    floor alone cannot keep a dark scene dark.
2026-09-30 Training report: v4-dark, the deployed IMX477 look
    v5 (trained without the normalisation lifts) failed its held-out gate, so
    the deployed look pairs v4's LUT with gamma 1.0-1.25 and stretch cap 1.5,
    judged on 316 frames.
2026-09-30 Pi photo volume: move ~/Pictures/pifilm onto a fixed-size image
    The SD card's root partition fills the card, so photos (14 GB after a
    month) and the OS share one filesystem. scripts/pi_photo_volume.py puts
    the photo folder on a preallocated ext4 image mounted over the same path,
    verified by a checksum dry run before the old folder is moved aside, with
    an immutable bare mount point and RequiresMountsFor drop-ins so nothing
    falls back to writing on root.
    [test_pi_photo_volume.py]
2026-09-30 Pi photo volume: keep the image's space reserved
    mkfs.ext4 discards the device by default, which on an image file punches
    holes and undoes the fallocate reservation (30 GiB image, 15 GiB allocated
    on the first run). Format with -E nodiscard and keep the weekly fstrim
    off the mount with X-fstrim.notrim.
2026-09-30 nextcloud_sync: exclude lost+found at the photo volume's root
    On the new ext4 photo volume rclone hit the root-only lost+found and every
    sync failed with exit 6 (permission denied).
    [test_nextcloud_sync.py]
2026-09-30 pifilm-process: grade with the EV and grain seed from captures.jsonl
    A regrade ignored the capture log, so every frame was graded at EV 0 (the
    normalisation then undid deliberate exposure compensation: 33 of 53 frames
    on 2026-09-29, and one at EV -2) with new random grain. Frames now use
    their logged ev_comp and grain_seed; checked on the 2026-09-29 folder,
    which regrades pixel for pixel as the Pi pipeline does. Double-exposure
    frames are graded singly with their own EV. --ignore-log restores EV 0.
2026-10-01 Grain: two_scale model measured from HP5 Plus 400 scans
    Fine and coarse clumps sized in millimetres of a 36 mm frame (4.3 and 11.2
    um, 76% fine) with the measured brightness envelope, pinned to zero at
    black and white. Artifacts that use it are written as params version 3, so
    an older build refuses them instead of reading the fields as Gaussian
    grain at six times its strength; Gaussian artifacts stay version 2 and
    byte-identical.
2026-10-10 display: move the shared touch types out of the CST3530 driver
2026-10-10 viewfinder: follow the display's scale and skip dimming where there is none
    [test_viewfinder.py, viewfinder.py]
2026-10-10 display: DSI panel driver through DRM/KMS
2026-10-10 display: check the mode-set at open, contain driver errors, drop start-up touches
    [app.py, kms.py, test_display_kms.py, test_viewfinder.py, viewfinder.py]
2026-10-10 docs: GPIO shutter button plan
2026-10-10 capture: a shutter button on one GPIO pin
2026-10-10 pifilm-capture: --shutter-gpio, a physical shutter button
2026-10-10 capture: report a missing GPIO backend as a pin failure, not a missing library
    [button.py, test_capture_button.py]
2026-10-10 docs: the GPIO shutter button
2026-10-10 capture: nothing escapes the button's callback or its close; docs follow-ups
2026-10-10 docs: GPIO shutter button hardware acceptance results
2026-10-10 capture: a camera that stops delivering frames is a logged stall and a restart, not a frozen process
    Seen on the Pi 4 on 2026-10-10: the sensor kept streaming but Picamera2
    stopped handing preview frames over. capture_request() had no timeout and
    was called holding the request lock, so the viewfinder froze, the next
    shutter press queued behind it, and systemd saw a healthy process.
    Every read now waits a bounded time (5 s preview, 30 s still, plus four
    fixed shutters) and raises CameraStalled with Picamera2's state in the
    message. Three stalled preview reads in a row end the viewfinder and
    pifilm-capture exits 1 for a systemd restart, with a 10 s deadline on the
    clean-up in case closing the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
    [app.py, errors.py, picamera.py, test_app.py, test_picamera.py, test_viewfinder.py, viewfinder.py]
2026-10-11 viewfinder: manual white balance in kelvin (WB pill, --white-balance)
    Auto white balance reads cold with a tele lens mounted. A WB pill beside
    the double-exposure toggle steps A -> 3200 -> 4000 -> 5000 -> 5600 ->
    6500 -> 7500 K -> A; --white-balance K sets the starting value.
    Picamera2Camera.set_colour_temperature writes ColourTemperature (or
    AwbEnable to return to auto) to the running camera and into both
    configurations, never both controls together. Measured on the IMX477
    with libcamera 0.7.2: the control alone fixes the gains, requests below
    2360 K are clamped. Each capture record carries colour_temperature_k.
    The pill is not drawn when --awb-lock or --colour-gains already fixed
    the whi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
2026-10-11 capture: manual ISO on Picamera2 and the fake camera, recorded per capture
2026-10-11 display: the SLR-finder live screen (liveview.py) and its bundled font
    A new pure module beside ui.py: full-screen image, a solid black strip with
    three select cells (SHUTTER, ISO, WB), one +/- pair, the shutter button at
    the top right well clear of the keys, a 13-dot meter, and the 2x, battery
    and focus read-outs. Drawn at twice the panel scale and reduced with
    Lanczos; everything static is cached as small tiles so a frame is the
    letterboxed preview plus a few pastes.
    The viewfinder loop still uses ui.render_live; Task 4 switches it over.
    The Barlow Condensed files and their package-data entry are already in the
    tree (f7964d8); this module is their first user.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
2026-10-11 viewfinder: select-and-adjust shutter/ISO/WB on the new live screen; EV removed
    The loop now draws liveview.py's screen. A tap on a strip cell selects SHUTTER,
    ISO or WB (only the ones the camera can change), and one +/- pair steps the
    selected control; the first step out of auto lands on the metered step. The
    keys light while a finger is on them and for 0.15 s after a tap, with actions
    still fired on release.
    Exposure compensation is removed: the viewfinder's EV state and buttons, the
    --ev flag, set_ev on both cameras and Picamera2Camera's ev parameter. camera.ev
    stays as a constant 0.0 and ExposureValue 0.0 is still sent, so records keep
    ev_comp and old ones regrade as before. The old liv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
2026-10-11 viewfinder: ignore controls during processing, accept presses up to 1.5 s; tidy-ups
    While the colour bars show, taps on the cells and on +/- are ignored like the 2x
    toggle's: no step, no selection, no flash. The shutter tap still reaches the
    controller. A key's flash is also dropped when the live view gives way to the
    bars or a review, so it cannot reappear on the first frame back.
    The viewfinder's tap detector takes TAP_MAX_HOLD = 1.5 s instead of the 0.6 s
    default: a key that lights under the finger invites a longer press, and one that
    lit and then did nothing reads as a fault.
    Tidy-ups: _ScaledDraw loses the four shape methods (and _points) the old live
    screen used; the cell indexes com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
2026-10-11 manual controls: final-review fixes (ISO errors contained, --ae-lock greys shutter/ISO, scale edges, docs)
    - set_iso and set_shutter build their controls inside the try, so a failed
    lazy enum lookup is a CameraError with nothing changed, not an exception
    that ends the viewfinder loop.
    - --ae-lock: Picamera2Camera.exposure_adjustable is False and set_shutter /
    set_iso refuse; the viewfinder greys SHUTTER and ISO. FakeCamera reports True.
    - A cell the camera cannot change shows its metered value without AUTO.
    - stepscale.up leaves a value above the top step alone (--white-balance 9000).
    - ISO steps above the sensor's gain limit are not offered (iso max_iso).
    - An unexpected touch read er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
2026-10-12 README: the display, the path from shutter button to saved photo, current hardware
2026-10-12 viewfinder: read frames on their own thread so the controls stay responsive at slow shutters
    Under run() a pifilm-frames thread reads preview frames on request and the
    loop redraws the latest one every step, so a tap is acted on and shown at the
    loop's rate whatever the shutter speed. Picamera2Camera's control setters take
    a configuration lock instead of the request lock: they no longer wait for a
    preview read, and a still holds both locks.
2026-10-12 viewfinder: verify fixed controls against the camera's metadata, resend or restart the live view, and trace each control step
    On the Pi 4 a control sent to the running camera has been seen not to take
    effect until a photo reconfigured the camera; the cause is not known. Each new
    frame's metadata is now compared with the fixed shutter, ISO and white balance.
    A mismatch lasting 3 s and 6 frames is logged and the controls are resent
    (Picamera2Camera.reassert_controls); after two resends without effect the live
    view is restarted (restart_preview), at most once a minute. Every successful
    step also logs one trace line about 2 s later with the selection, what the
    camera reports and the picture's R/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
2026-10-12 viewfinder: restart the live view at once when a white-balance change has not taken effect; one restart per selection
    Measured on the Pi 4 + IMX477 on 2026-10-12: after a photo a live
    white-balance change was ignored 11 times out of 11, a resend cured 2 of about
    7 and a restart of the live view cured 3 of 3, while a live shutter change was
    applied. White balance is therefore no longer resent: a mismatch lasting 1.5 s
    and 6 frames (4 s for a return to auto) restarts the live view. Shutter and ISO
    keep the resend-then-restart ladder. The 60 s restart hold-off is replaced by
    one restart per episode, with restarts never closer than 5 s.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
2026-10-12 viewfinder: one live-view restart per selection, no repeat for a still auto white balance; review follow-ups
    A control's restart is now spent per selection, not per episode, so a control
    that flaps between agreeing and disagreeing no longer blinks the live view
    every five seconds. A restart for an auto white balance that has not moved
    ends the watch on auto, so a capped lens or a dark scene costs one restart.
    The 5 s gap between restarts is counted from the end of a restart, the fps
    window is restarted after one, and a control whose metadata goes missing has
    its wait restarted.
2026-10-12 focus meter: choose edges by the frame's own spread, so a defocused noisy frame reads empty
    On the Pi 4 at ISO 1600 a lens left completely out of focus read 0.43 to
    0.67 of the bar, more than a slightly soft frame. The edge gate came from
    a noise estimate calibrated on white noise; the ISP's noise reduction
    leaves blotchy noise about five times stronger at the scale edges are
    chosen at, so most of a featureless frame passed as edges and its noise
    scored as detail. The one-level stairs of an 8-bit gradient passed too.
    An edge is now a pixel whose re-blurred step stands six robust standard
    deviations out of the region's re-blurred steps (and at least half a
    level), and a frame needs a minimum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
2026-10-12 capture: record how long each stage of a shot took (stage_ms)
    Step 1 of the pipeline-improvements roadmap. Every capture record now
    carries stage_ms: the whole camera read, Picamera2's own breakdown of it
    (mode switch and request, array copy, DNG extraction), the double-exposure
    composite, normalise, LUT, grain, and each file write. pipeline_ms and
    shutter_to_saved_ms stay.
    Pipeline.process takes an optional timings out-parameter and its audit
    dict is unchanged, so regrades are checked against the same fields as
    before. No pixel changes.
2026-10-13 Roadmap: the Pi's per-stage timings
2026-10-13 grain: read the envelope from a 256-entry table; same bytes, less than half the time
    The luminance the envelope is evaluated at is a byte, so the envelope times
    strength is a table indexed by Y, and only Y is made a float. Byte for byte the
    same output as before (tested against the previous implementation for both
    models), so no model or params version changes. One 12 MP frame on a laptop:
    HP5 grain 1584 ms to 683 ms, Gaussian 728 ms to 327 ms.
2026-10-13 grain: two_scale_tile, the HP5 grain laid down from a noise tile
    Building the noise field was over half of the grain stage on the Pi 4 and does
    not depend on the photograph. The new model builds it once as a seamless square
    tile (fixed seed, tile_px on a side) and places it per shot with an offset and
    one of eight orientations drawn from the shot's seed. Same clump sizes, mix,
    envelope and strength as two_scale; different pixels, so a new model name and
    params version 4. Existing artifacts and records keep their code path.
    One 12 MP frame on a laptop: 675 ms to 64 ms (tile built once, 235 ms).
2026-10-13 grain: build the tile at start-up, not during the first photograph
    On the Pi the first shot's grain took 1,266 ms against 706 ms for the next one.
    The session now warms the pipeline for the camera's still size on a thread.
2026-10-13 controller: report pending grades and close them before the camera
    ControllerSnapshot.pending_grades is read from the session when the snapshot
    is taken, so a display sees the count fall while no capture is running. A
    session without the property, one that raises, or one that answers with
    something that is not a count reads as 0.
    The worker closes the session's grades before the camera, and still closes
    the camera when that raises.
2026-10-13 capture: grade behind the shutter
    With background=True (--grade background, the command's default) a shot saves
    its original, writes a pending entry, makes a quick grade for the screen and
    the Stick, and hands the full frame to the grade queue. The worker grades,
    saves the graded file, appends the record and removes the entry. The graded
    file is byte-identical to the inline one for the same frame and seed.
    Entries left by a previous run of the same output folder are finished at
    start-up and marked recovered; one whose record is already in captures.jsonl
    is only removed. A full queue makes the next capture wait; a closing queue
    hands the shot back and it is graded on the capture thread after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
2026-10-13 liveview: show how many photographs are still developing
    An amber number on a dark patch beside the battery tag, from the
    controller snapshot's pending_grades at every live frame. Nothing is
    drawn at zero, and numbers above 99 are drawn as 99.
    It sits on the battery tag's right, not its left: the 2x tag ends two
    units before the battery tag, so there is no room between them.
2026-10-13 capture: sync a background grade before its entry goes; stop cleanly on SIGTERM
    The grade side now syncs the graded JPEG and the captures.jsonl append before
    it removes the pending entry: on ext4 the removal can reach the disk before
    data that was only written, and a power cut then left no entry, no record and
    an empty graded file. The inline path is unchanged and syncs nothing.
    A log whose last line was cut short gets a newline before the next record
    written by the grade side, so a record never joins half of another.
    main turns the first SIGTERM into the same exit as Ctrl-C, so systemd's stop
    runs the clean-up and the queued grades are finished in headless mode too.
    Outside the main threa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
2026-10-13 background grading: sync originals, short stops, clean-up immune to SIGTERM
    The original (and the DNG) of a background shot is synced before its pending
    entry is written, so an entry can no longer outlive the file it names. Inline
    captures sync nothing, as before.
    GradeQueue.close drops recovery-backlog jobs that have not started; their
    entries stay for the next start. The running job and those accepted through
    submit are still finished, and pending reaches 0.
    Every clean-up begins by ignoring SIGTERM: the viewfinder's handler takes the
    first one and left main's unfired, so a second raised inside
    controller.close() and the camera was not closed.
    The grade side waits at most 5 s to be told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
2026-10-13 capture: sync the original and the DNG on the grade worker, not before the camera is free
    On the Pi's SD card the two syncs took 0.8 to 1.5 s a shot (save_dng 27 ms to
    557-1,114 ms, save_original 343 ms to 480-1,107 ms), most of what grading behind
    the shutter had gained. The worker now syncs them as its first step. For the
    second or so between, a power cut can lose that photograph; before background
    grading nothing was synced at all.
2026-10-13 imageio: save_jpeg takes a four-byte image, the fourth byte ignored
    The GPU reads its result back as four bytes a pixel; the encoder takes
    that buffer in place (Pillow RGBX) and writes the same file as from three
    bytes. Anything that is not uint8 (H, W, 3) or (H, W, 4) is refused before
    the file is touched.
2026-10-13 gpu: the grader, with its self-test and what it does when the device fails
    GpuGrader drives a narrow Device: it loads the LUT, grades a small fixed
    frame and compares it with the NumPy reference before it is trusted, places
    the grain with the draw the CPU makes, refuses what the pass does not cover
    or a call from another thread without touching the device, and turns every
    failure into GpuError so the caller grades that photograph on the CPU.
    Three failures in a row switch it off for the run.
2026-10-13 gpu: the EGL device, the spike's GL code as the grader's Device
    ctypes on libEGL and libGLESv2, loaded inside open_device and never at
    import. The call sequence, constants and formats are those that ran on the
    Pi 4 on 2026-10-13; the module docstring lists each difference (textures
    deleted when replaced, the context released on close, EGL_PLATFORM put
    back, argument types on the GL functions that take a pointer). The tests
    run it against a recording stand-in for the two libraries.
2026-10-13 gpu: pifilm-gpu-check, the full-frame comparison with timings
    Grades a photograph (or a synthetic 4056 x 3040 frame) on the GPU, prints
    each pass's timings beside the CPU pipeline's, and exits 0 only when no
    pixel is more than one level from the NumPy reference.
2026-10-13 pipeline: process takes a GPU grader, and falls back to the CPU for the same frame
    With a grader that can take the frame, the statistics are computed here and
    the pass runs on the grader. A GpuError puts the generator back where the
    caller gave it and grades on the CPU, so the result is the CPU's own bytes.
    used["backend"] says which graded; used["gpu_error"] carries a failure.
2026-10-13 gradequeue: on_start and on_stop, run on the worker thread
    For what belongs to the worker's thread for its whole life (the GPU grader's
    graphics context). A hook that raises is logged and never ends the worker.
2026-10-13 gpu device: no error flag or half-made texture outlives a failure
    The GL error is read before the framebuffer's status is judged, so an
    allocation that ran out of memory reports its own code and leaves no flag
    for the next pass. A table, tile or LUT whose load failed is deleted and
    forgotten, so the next load makes its storage again. The docstring no
    longer claims the process does not stay surfaceless.
2026-10-13 gpu grader: only GpuError leaves grade and the self-test; the self-test's tile skips the cache
    The placement draw and the self-test's statistics, tile and reference are
    under the wrappers now. The self-test's small tile is built beside
    grain_tile's two-slot cache, so it cannot evict the tile the session warmed.
2026-10-13 capture: the grade worker grades on the GPU; --grade-backend; pipeline_backend in records
    With --grade-backend auto (the default) and background grading, the grade
    worker opens a GpuGrader before its first job and closes it after its last,
    both on its own thread. A photograph the GPU fails on is graded on the CPU in
    the same call and named in one log line. Inline sessions, --grade-backend cpu,
    the quick grade and a shot a closing queue refused stay on the CPU.
    Every record of a graded photograph gains pipeline_backend (gpu-1 or cpu).
    Three existing record-order assertions now leave that field out of the
    comparison, since it sits after stage_ms inline and after grade in background.
    Co-Autho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
2026-10-13 capture: a marker keeps a hanging GPU open from stopping every start
    The grade worker writes gpu-opening beside the state directory before it opens
    the GPU and removes it when the open returns. A start that finds it does not
    open the GPU, says so in one line and grades on the CPU. Also a test for a
    frame wider than the largest texture, and the module docstring now says inline
    records carry pipeline_backend.
2026-10-14 docs: a Pi camera regrade starts from the quality-95 original; the GPU's Pi numbers
    The Pi camera's original is a JPEG of the frame the Pi graded, so pifilm-process
    never reproduced those photographs exactly, GPU or CPU. Measured 2026-10-14 on
    sixteen GPU-graded photographs: 0.7 to 2.1 levels on average, at most 18 to 27.
2026-10-14 tuning: fingerprint, resolve and check the libcamera tuning in use
2026-10-14 pifilm-tuning: print the tuning's fingerprint and stamp a look with it
2026-10-14 pifilm-train: --tuning-sha1 writes the tuning's fingerprint into the look
2026-10-14 picamera: fingerprint the tuning at open and report it as tuning_sha1
2026-10-14 capture: check the camera's tuning against the look at start-up; records carry tuning_matches
2026-10-14 viewfinder: an amber TUNING tag while the camera's tuning differs from the look's
    ControllerSnapshot.tuning_mismatch is read from the session like the developing
    count and passed into LiveState.tuning_mismatch. The tag is drawn last in the
    top-left tag row on the count's dark patch. The tag tile widens from 112 to 124
    units so "AC 100%", a two-digit count and TUNING fit; renders without the tag
    are byte-identical to before.
2026-10-14 tuning: the automatic case is the sensor's default file only
    Picamera2 0.3.x removes LIBCAMERA_RPI_TUNING_FILE from the environment when
    it opens a camera without a tuning, so the service never used it while
    pifilm-tuning honoured it, and the two could disagree. resolve() loses the
    environment branch and its environ parameter; ENV_VAR is gone. The
    --tuning-file help says a bare name is searched in libcamera's tuning
    directories and anything else must be an absolute path.
2026-10-14 docs: review fixes for the tuning check
    The spec gains a dated amendment: LIBCAMERA_RPI_TUNING_FILE is ignored,
    because Picamera2 clears it. Acceptance step 3 names the edited copy by an
    absolute path. training.md step 7 says to run pip install -e . again, to
    stamp as george without sudo, and to stamp the Mac's copy too so a later
    rsync does not silence the check. Records carry tuning_sha1 only when the
    tuning could be fingerprinted, from this build on.
2026-10-14 experiment: exposure placed from the camera's Lux reading (step 5), gallery script
    Four columns per photograph: the deployed look, the median placed from Lux by
    the levels gamma, the same target by a plain gain with highlights protected,
    and the camera's own exposure. Offline only; no default changes.
2026-10-14 docs: adaptive contrast changes 1 to 4 levels, no change; second preview stall and the journal to-do
2026-10-14 raw: the developer's tables from a libcamera tuning file
    tuning_tables reads the black level, colour matrices, lens-shading grids
    (luminance table at luminance_strength, as libcamera's alsc.cpp applies
    it) and the gamma curve, checking every size. ccm_at and alsc_at
    interpolate linearly in colour temperature and clamp at the ends.
2026-10-14 raw: refuse a NaN level or ct and a nested table; test the remaining refusals
    Review points on the reader: a zero-denominator white level, a black
    level not below white, a NaN or infinite colour temperature and a nested
    tuning list are now RawErrors. Tests cover a strip or tag data past the
    end of the file and an odd width at 12 bits.
2026-10-14 raw: develop a DNG to sRGB with the camera's tuning
    develop runs black level, lens shading, white balance, demosaic, colour
    matrix and tone curve in the ISP's order, with the tables at the shot's
    colour temperature. The Cr/Cb shading tables are divided by their minimum
    as libcamera does; white balance clips to 1 before the matrix so a
    clipped highlight stays white. Tone 'isp' is the tuning's gamma curve,
    'soft-<e>' lifts the shadows e stops first; as_float returns the picture
    before rounding. The float stages run in row bands.
2026-10-14 plan: lens-shading colour tables are divided by their minimum, as libcamera does
2026-10-14 experiments: raw base gallery, DNGs developed beside the camera JPEG
    Develops every IMX477 DNG with each tone curve from the shot's own gains
    and colour temperature, validates isp against the camera's JPEG (signed
    and absolute per channel, centre-to-corner shading, per Lux bin), and
    compares +/-2 stop pushes of uint8 and float developments on the 6
    darkest and 6 brightest scenes.
2026-10-14 raw: digital gain, consistency checks, refused tags and stated limits
    develop takes the record's DigitalGain (the ISP's applyDG, after the
    DNG's samples) with the colour gains before the clip; refuses a DNG whose
    AsShotNeutral disagrees with the gains by more than 0.5 % and, at 12
    bits, a tuning whose black level is not the frame's. read_dng refuses
    LinearizationTable, ActiveArea, a DefaultCrop smaller than the frame and
    an orientation other than 1. The docstring states the full-field-only
    limit and the ISP's grid and fixed-point differences. New tests: an
    asymmetric shading grid, ALSC taken at the colour temperature, a clipped
    corner under luminance gain.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
2026-10-14 experiments: raw gallery passes DigitalGain and checks colour shading
    Each shot is developed with its record's DigitalGain (1.0 when absent).
    The validation adds corner-minus-centre log(R/G) and log(B/G), isp minus
    camera, to summary.json and the printed and page tables, so a colour
    lens-shading error shows where the brightness ratio cannot see it.
2026-10-15 pi_journal: keep the Pi's journal across reboots, and report the capture service's restarts
    Raspberry Pi OS keeps the journal in memory, so the restarts of 2026-10-15
    left nothing once the Pi had been switched off. A journald drop-in sorting
    after the OS's volatile one keeps it on the card (200 MB cap, 1 GB kept
    free); --report lists every boot's starts, stalls and error exits, the
    lines before each exit, and undervoltage or out-of-memory messages.
2026-10-15 capture: a disk-space monitor for the photo volume and the SD card
    DiskMonitor measures df's Use% (rounded up) of the photo folder and of /, once
    when it is the same filesystem, on a pifilm-disk daemon thread every 60 s. It
    logs one line when a filesystem reaches the threshold and one when it recovers,
    skips a path that cannot be measured after one line, and holds the current
    warning for display threads.
2026-10-15 capture: --disk-warn-percent and the disk warning in the controller snapshot
    main has the session make a DiskMonitor over the photo folder and / for every
    loop, started and closed beside the UPS poller, at --disk-warn-percent (1-100,
    default 90). CaptureSession.disk_warning holds the current warning and
    ControllerSnapshot.disk_warning carries it, read like the developing count.
2026-10-15 viewfinder: amber PHOTOS and SD tags while a filesystem is low on space
    ControllerSnapshot.disk_warning is passed into LiveState.disk_warning and drawn
    from its own cached tile between the top-left tag row and the shutter button, in
    the TUNING tag's style, photos first. PHOTOS 100% and SD 100% together span 127
    to 208 units at scale 1 (206 at scale 2), short of the shutter's hit circle at
    253. Renders without a warning are byte-identical to before.
2026-10-15 capture: a network monitor for the eth0 and wlan0 addresses
    NetworkMonitor reads, on a pifilm-network daemon thread every 10 s, the IPv4
    address of eth0 and wlan0 while sysfs reports the interface up (SIOCGIFADDR
    through fcntl.ioctl; any failure there is no address). It logs one line when an
    address appears or changes and one when it goes, one line per spell of failed
    reads, and holds the current addresses for display threads, ETH first.
2026-10-15 capture: the network addresses in the controller snapshot
    main has the session make a NetworkMonitor for every loop, started and closed
    beside the disk monitor. CaptureSession.network holds the current addresses and
    ControllerSnapshot.network (a new last field) carries them, read like the disk
    warning: a missing, raising or malformed value reads as none.
2026-10-15 viewfinder: pin that no address never builds the network tile; comment beside its box
2026-10-15 docs: Nextcloud sync over the home network, wired or Wi-Fi
2026-10-15 sync: the Nextcloud sync in the package, one run at a time
    The sync moves to pifilm.nextcloud so the capture service can run it with
    python -m pifilm.nextcloud; scripts/nextcloud_sync.py stays as a wrapper for
    the installed timer unit. A non-blocking flock on --lock (default under
    $XDG_STATE_HOME/pifilm) keeps the menu's upload and the timer's run from
    running rclone twice over the same files. parse_env_file is copied into
    pifilm/envfile.py, since the firmware script runs without the package.
2026-10-15 capture: an upload to Nextcloud run as a child process
    Upload starts `python -m pifilm.nextcloud --apply --env PATH` without
    PIFILM_REMOTE_TOKEN in its environment, logs each line as `nextcloud: ...`
    on a pifilm-upload thread, and turns the exit and last line into the
    settings menu's UPLOAD row text. close() terminates, then kills.
2026-10-15 capture: auto-exposure modes and DNG saving changed while the camera runs
2026-10-15 viewfinder: a MENU key on the live view; the addresses leave it
    A MENU pill in the keys' style sits between the shutter and +, centred at
    (287, 88), 40 x 14; its hit box is the pill grown by 3 units (y 78 to 98),
    clear of the shutter's circle (ends at y 73) and +'s (starts at y 104). It is
    a new Action.MENU in PRESS_KEYS, so it lights under a finger like the keys.
    The ETH/WLAN network tile and LiveState.network are removed; the addresses
    move into the menu. ControllerSnapshot.network and the monitor stay.
2026-10-15 viewfinder: the settings menu page
    A black page of label/value rows, x 8 to 248 from y 8, 20 units each,
    and a DONE key on the shutter's centre and hit circle, drawn from the
    live view's canvas, fonts and colours. Values are cut with ... to the
    room the label leaves. Rows and DONE are cached tiles; the page is
    cached by rows, scale and press. menu_hit returns DONE, a row index or
    None; the gap between the rows and DONE's hit circle is nothing.
2026-10-15 viewfinder: the MENU state
    The MENU key opens the settings page and DONE returns to the live view.
    Rows step the settings through SettingsControl, start an upload, show the
    addresses and the look, and RESET takes two taps within 3 s. A shot from
    the GPIO button or the Stick that finishes while the menu is open is
    counted but opens no review, no colour bars cover the page, no frames are
    asked for, and the page is pushed only when its rows or DONE's press change.
2026-10-15 capture: the settings menu wired into pifilm-capture
    settings.json is read beside the state directory once the backend is
    known and before the panel and camera open; on Picamera2 a saved value
    wins over the unit's flag, under --fake or V4L2 the arguments stay as
    given. The menu's control gets appliers for DNG saving and the two AE
    modes, the viewfinder the rows the camera supports (no AE rows under
    --ae-lock), the look's name, and with --nextcloud-env and a panel an
    Upload that main closes beside the network monitor.
2026-10-15 viewfinder: no reset without settings rows; docs
    RESET appears only when the menu has settings and setting rows: under
    --fake it would only delete the real camera's settings.json. The docs say
    a USB camera has no menu at all, and that stopping an upload stops its
    rclone too. The controls tile's cache holds all five pressed variants.
2026-10-16 viewfinder: the MENU key under the - key
    The owner wants the right edge above the strip kept for the shutter and the
    camera's controls. The pill moves to (287, 199), 40 x 12, between -'s hit
    circle and the strip; its hit box is MENU_HIT_BOX (264, 190, 311, 215), x0/y0
    included and x1/y1 excluded, reaching into the strip's meter part, which has
    no tap action. The controls tile grows to y 207 to hold it. The old MENU place
    is NONE again; every other hit is unchanged.
2026-10-17 gpu: halation in the pass, shader version 2
    The glow is made on the CPU by pifilm.halation.prepare from the normalised
    bytes and read back in the shader with a hand-written bilinear read; the
    reference mirrors the shader step for step. The device gains the glow
    texture and the hr/hw float uniforms, the grader makes the glow, times it
    and runs the self-test with it, and pifilm-gpu-check hands it to the
    reference. Tests pinning "gpu-1" now use the shader's BACKEND.
2026-10-17 halation: two reduced pixels of sigma, the CPU mix in bands
    The quick grade (1014 px, inside shutter_to_ready_ms) made its glow
    unreduced at four reduced pixels of sigma: 588 ms on the Pi 4 against
    137 without halation. Two pixels give k 3 there and 14 at 12 MP; the glow
    stays within 6 % of its peak of the full-size blur, a level after the mix.
    apply_cpu works in bands of rows, reading each band's glow with glow_at,
    the shader's bilinear read moved here from the GPU reference (which now
    calls it), so a 12 MP frame needs no full-size float copy, and encodes to
    sRGB through a 65,536-entry table (within 0.03 of a level of the curve).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
2026-10-17 docs: halation's two-pixel reduction rule, the banded CPU mix
    The spec's reduction rule with its dated amendment (the quick grade's
    cost), the shutter-side correction to its costs, and the banded CPU step;
    the write-up's third difference from the gallery; CLAUDE.md's halation
    bullet and the current test count.
2026-10-23 settings, camera: sharpness, contrast and saturation as menu settings
    Three new settings keys stepping through 0.5 to 1.5 (1.0 is the ISP's
    normal), still settings.json version 1. Picamera2Camera opens with them
    and changes one live with set_image_control, writing both configurations
    like the AE setters; a control the camera does not list is refused and
    left out of stream_info. Every Picamera2 record carries the three values
    right after ae_metering, copied when the photo is taken, so background,
    recovered and double records keep the values of their shutter.
2026-10-23 display: the menu's IMAGE page for sharpness, contrast and saturation
    An IMAGE row after the setting rows opens a second page with a title:
    the three controls step through 0.5 to 1.5 and wrap, its RESET (two
    taps) puts only those back to 1.0, BACK returns to the first page and
    DONE closes the menu from either. The row is dim on a camera that can
    change none of them, and a control the camera lacks is dim on the page.
2026-10-23 display: an amber IMG tag while sharpness, contrast or saturation is not 1.0
    LiveState.image_adjusted, read by the viewfinder from the menu's own
    settings (only for controls this camera takes). Drawn first in the disk
    warning's tile: the tag row has no room after TUNING, and with the widest
    disk warning beside it the tile still ends at about 233 units, short of the
    shutter's hit circle.
2026-10-23 picamera: the live view denoises at Minimal, stills keep HighQuality
    The shared control dict set HighQuality in the preview configuration too,
    overriding Picamera2's own preview default. The preview now gets its own
    copy with Minimal (left out with the still's on an older libcamera), the
    camera starts with the preview's controls, and every runtime setter writes
    only its own control, so a still from the live view is still configured
    with HighQuality.
2026-10-23 docs: the menu's IMAGE page, the IMG tag and the image control fields
    lcd-viewfinder: the IMAGE row and page, the IMG tag, the training caveat
    and two hardware acceptance steps. training: keep the three at 1.0 for
    source frames. how-it-works: the ISP's controls come before the look.
    CLAUDE.md: seven settings, set_image_control and the record fields, the
    second page and the IMG tag.
2026-10-23 plan: stabilise (short exposure, shutter delay, multi-frame merge)
2026-10-23 settings, picamera: short exposure, shutter delay and multi-frame settings
    The three helps against camera shake are stored in settings.json
    (short_exposure, shutter_delay, multi_frame; validated against the menu's
    values). Short exposure is libcamera's AeExposureMode, sent at open in both
    configurations, changed live by set_short_exposure and recorded right after
    saturation. The delay and the burst are stored only for now.
2026-10-23 controller, viewfinder, button: the shutter delay
    A press on the LCD's shutter or the GPIO button now asks for the menu's
    shutter delay, read at the press; the controller's worker waits it out on
    an event close sets (a job still waiting then fails as closed and never
    captures), and the job stays active meanwhile, so a second press is busy.
    The Stick and the keyboard ask for none. The session is told the delay
    (capture(delay_s=)) and Picamera2 records carry shutter_delay_s right
    after the stream fields, in the pending entry too, so background and
    recovered records keep it. Off Picamera2 the delay is 0.0 and unrecorded.
2026-10-23 controller, viewfinder: the live view goes on through the shutter delay
    The photographer holds the framing during the wait, so a job waiting out
    its delay is no longer marked processing: it stays queued (the Stick's
    status API is not told a capture is under way) and the snapshot gains
    delaying, set at submit. It still counts as active, so a second press is
    busy. The viewfinder draws colour bars only once the capture starts,
    keeps its keys live and keeps asking for preview frames through the
    wait; the captures-only window likewise draws its loading screen only
    when the capture starts.
2026-10-23 picamera, camera: burst capture with a split exposure
    Picamera2Camera.read_burst(n, split_exposure=) switches to the still
    configuration once, takes n requests back to back and returns to the live
    view, with read(full=True)'s locks and timeouts. A split burst (shutter and
    ISO auto) takes t/n at min(g*n, max_gain) from the latest live metadata, or
    from one frame's metadata captured in still mode, and puts back the still
    configuration's exposure controls and the running camera's afterwards, also
    on a stall. Returns (frames, {"exposure_us", "gain", "split"}). FakeCamera
    (with an optional deterministic shift) and V4L2Camera read n frames unsplit.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
2026-10-23 picamera, camera: a burst can skip its DNGs; one frame-count check
    read_burst(..., dng=False) writes no DNG for any frame even with saving on
    (each 12 MP DNG was written between two requests, a long gap between the
    frames); the default keeps one per frame. FakeCamera and V4L2Camera accept
    and ignore it. The three read_burst use one burst_count check.
2026-10-23 stack: align a burst with ECC and merge it, ghost-weighted, in linear light
    pifilm/stack.py: merge(frames, reference=) aligns each frame to the
    reference with Euclidean ECC on luma reduced to about 1000 px, drops a
    fit that fails, ends under correlation 0.5, shifts over 5% of the width
    or rolls over 2 degrees, warps once at full size, and takes a weighted
    mean in linear light (weight exp(-(d/0.05)^2) on the luma difference),
    in bands of rows. The sRGB<->linear tables move from double.py to
    color.py, unchanged.
2026-10-23 app: multi-frame photographs (burst, frames on disk, merge, grade, record)
    The session's multi_frame (the MULTI-FRAME setting, applied on Picamera2) is
    read at the shutter. Above 1 a shot is read_burst(n, split_exposure=True,
    dng=False); the reference is the highest FocusFoM. The reference is
    HHMMSS_original.jpg and the others HHMMSS_frame2..N.jpg, all written by the
    capture side. Behind the shutter the pending entry lists the reference first
    with "stack": {"reference_index": i}; the worker merges (stack.merge) and
    grades, and a recovered grade merges the saved JPEGs. The quick grade is the
    reference frame alone. A double exposure never takes a burst. The record gains
    "stack" right after shu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
2026-10-23 batch: a multi-frame record regrades the merge of its frames
    A record with ``stack`` regrades pifilm.stack.merge of its listed frames with
    the reference first, as the Pi's grade worker does, so the regrade reproduces
    the Pi's file. A listed frame missing from the folder leaves the reference to
    be graded alone, counted in the run's note; --ignore-log grades the reference
    alone. ``_frameN`` files are never inputs, whatever --all says.
2026-10-23 display: the menu's STABILISE page and the STAB tag
    The first page's STABILISE row (after IMAGE) opens a titled page built on the
    IMAGE page's mechanism, now one table of pages: SHORT EXPOSURE (ON/OFF), SHUTTER
    DELAY (OFF/0.2 S/0.5 S) and MULTI-FRAME (OFF/2/4/6), each tap stepping and
    wrapping, a RESET for only those three (SettingsControl.reset_stabilise, two
    taps) and BACK. Dim on V4L2 and fake; SHORT EXPOSURE is dim without libcamera's
    exposure modes or under --ae-lock. The fullest first page, eleven rows, ends at
    y 228. An amber STAB tag follows IMG while any of the three is on; IMG and STAB
    take half the tag padding so both fit beside the widest disk warning.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
2026-10-23 docs, scripts: the stabilise features documented; bench_stack times the merge
    scripts/bench_stack.py times pifilm.stack.merge on a record's frames or a
    list of JPEGs (median of 3, frames used, peak RSS), for deciding on the Pi
    whether six frames stays. CLAUDE.md, lcd-viewfinder (STABILISE page, STAB
    tag, acceptance steps), how-it-works (the merge) and known-issues (merge
    limits not yet checked on real frames). The Pi 4 timing is a placeholder,
    PI4_MERGE_TIMING_TBD.
2026-10-24 picamera: a burst splits only fresh live metadata, else captures it now
    The viewfinder reads no frames with the screen off, in MENU, REVIEW or a
    notice, so a GPIO or Stick shot could split AE values minutes old. Live
    metadata older than LIVE_METADATA_MAX_AGE_S (1 s) or two of its exposures
    is replaced by one capture_metadata. The gain-capped split and the ignored
    DigitalGain are documented as deliberate.
2026-10-24 stack, capture: per-frame merge diagnostics; a recovered burst survives an unreadable frame
    stack.merge records, per frame, ECC's rho and the reason a frame was left
    out (ecc_failed, low_correlation, shift, angle; unreadable via
    unused_entry). The record's stack.aligned also carries each frame's own
    exposure_us and gain, kept in the pending entry as frame_exposures.
    A recovered multi-frame grade loads its frames one by one: a frame after
    the reference that cannot be read, or is not the reference's size, is one
    log line and an unused 'unreadable' entry; the rest are merged, or the
    reference graded alone. Only an unreadable reference fails the grade.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
2026-10-24 capture, batch, docs: the review's minor findings
    - main passes short_exposure False under --ae-lock, so a saved ON is not
    recorded true with no auto exposure to shorten.
    - pifilm-process grades a multi-frame reference alone when its frames
    cannot be read or merged (merge's ValueError), counted in the note,
    instead of ending the run.
    - viewfinder _shutter_delay docstring: the live view stays up while the
    job is delaying.
    - CLAUDE.md: STABILISE is dim on --fake; V4L2 has no menu.
    - lcd-viewfinder, photo-volume: a 6-frame shot is about six JPEGs on the
    photo volume and in the sync, so the disk warning comes sooner.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
2026-10-24 docs: the merge's Pi 4 timings and memory, measured; the Pi 4 has 4 GB
    bench_stack.py on the Pi 4 (2026-10-24), six 12 MP frames made from one
    photograph: 2 frames 2.9 s, 4 frames 6.1 s, 6 frames 9.4 s, all frames used,
    peak 640 MB. Writing a 12 MP JPEG takes about 0.47 s, so a 6-frame shot holds
    the camera about 4 s. The board is a 4 GB Pi 4 (revision c03114), not 8 GB.
2026-10-24 viewfinder: the settings menu as a tree of CAMERA, PIPELINE and NETWORK
    The first page now holds three categories, the read-only LOOK and the
    RESET of every setting. CAMERA holds IMAGE, AE CONSTRAINT and AE
    METERING; PIPELINE holds SAVE DNG, HALATION and STABILISE; NETWORK holds
    ETH, WLAN and UPLOAD. Every page names its parent, BACK goes up one
    level, DONE closes from any page, and a category is dim when none of its
    rows is active. The settings pages' RESET is a callable, not a method
    name looked up by string. Navigation only: no setting changes.
2026-10-24 viewfinder: the MENU key in the bottom strip, between WB and the meter
    The key leaves its place under - for the strip: cells narrowed to a 54-unit
    pitch (widest value "1/2000" is 44 units in the bundled font), the meter's
    left end moved to 240 (13 dots 5.5 units apart, text centred over them), and
    the key's hit box (170, 204, 230, 240) between WB's hit column and the
    meter's - glyph. The key is its own cached tile; the place under - stays empty.
2026-10-24 viewfinder: preview renders of every screen; docs for the menu tree
    scripts/render_menu_preview.py draws the live view (MENU key unlit and lit)
    and every menu page with the real drawing code and the viewfinder's own row
    builders, plus a labelled contact sheet, at scale 2 or 1. The docs describe
    the CAMERA/PIPELINE/NETWORK tree and the MENU key's place in the strip, and
    the acceptance steps walk the tree.
2026-10-24 liveview: a dead band between the WB cell and MENU; the meter gap comment made exact
    The WB cell's hit column and MENU's hit box touched at x 170, so a finger
    sliding from one to the other lit one and fired the other. MENU's hit box
    now starts MENU_CELL_GAP (3) units later; the pill stays where it was.
    The meter comment now gives the real dark gap beside the lit dot.
2026-10-24 cst3530: clamp a touch past the glass's edge to the frame
    to_display mapped a raw point past the panel's edge to y 240 or more,
    which the strip cells' hit test (any y below their top) still took for a
    tap. Clamp the raw point to the portrait panel first, as evtouch does.
2026-10-31 README: Agfachrome samples from the latest look; training report names D
    Three photographs from the HQ Camera graded on the Pi with
    agfachrome-2026-10-d-dark (lut ae4fd640), resized to 2000 px. The
    training report now records candidates C and D and that D is deployed.
2026-10-31 README: a fourth Agfachrome sample, the pond
2026-11-12 camera-body: the πTone 500 printed body, STLs, renders and a build guide
    A waist-level box body that replaces the X728-C1 case: Pi 4 + X728 + extra 18650 holder,
    HQ camera in the lens board, Waveshare 3.5" DSI LCD (E) under a fold-up hood. Dimensions
    checked against measurement photos of the real parts (2026-11-12); nothing printed yet.
2026-11-12 Remove the remote capture API and its Stick-only pieces
    pifilm/capture/remote.py, --remote-listen and PIFILM_REMOTE_TOKEN go, with the
    thumbnail endpoint (fitted_jpeg) and their tests. The double exposure's
    "Exposure 1/2" card moves to pifilm/display/ui.py; the captures window still
    shows it as exposure 1's picture. The GPIO button still selects the
    shared-controller loops and, with no screen and no terminal, keeps the process
    up (_wait_for_button). A viewfinder whose display fails repeatedly now always
    exits 1 for a systemd restart. The Nextcloud upload child no longer strips a
    token that does not exist. The service unit drops --remote-listen and its
    EnvironmentFile; .env.example drops the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
2026-11-12 docs: drop the StickS3; docs/pi-service.md replaces docs/sticks3-remote.md
    The network and service guide keeps everything still true: Ethernet
    administration, the field hotspot (now for a phone or laptop to SSH in, with
    PI_HOTSPOT_ADDRESS), the pmf=1 and powersave=2 rationale, the systemd service
    install, the passwordless sudoers rule and rollback. setup.md loses the Stick
    step and the token file and is renumbered; README, the viewfinder, UPS, sync,
    photo-volume, bring-up, training and known-issues docs describe the GPIO
    button and the LCD where they named the Stick. Recorded hardware results are
    left as run, with a note where the trigger has since been removed.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
2026-11-12 CLAUDE.md: drop the StickS3, its firmware and the capture API
    Point at docs/pi-service.md, describe the hotspot as a field access point
    with PI_HOTSPOT_ADDRESS, and the GPIO button as the trigger the headless
    service keeps.
2026-11-12 README: bring it up to date in a simpler style
    Adds what landed lately and was missing: halation, multi-frame and shutter
    delay, the settings menu, the amber screen tags, the tuning check, GPU
    grading details, the πTone 500 printed body, every pifilm-* command, the
    newer capture flags, and links to the UPS, photo volume and journal guides.
    Fixes stale facts: the pipeline order, DNG being optional, the empty
    Getting started section, the STL promise. Drops the two Stick photos
    nothing links to any more.
